j-glow/chwytak/mes/blok/PerformanceLog.txt

Number of Contacts: 0
Number of contact data: 0
