j-glow/chwytak/Sprawozdanie.docx

# Zakład Podstaw Kontrukcji

# ITLiMS, MEiL, PW

Podstawy Konstrukcji Maszyn

Rok akademicki 2022/2023, semestr zimowy

Projekt Chwytaka

Sprawozdanie z procesu projektowego

Autor

Jakub Głowacki

# 1 Wstęp

Chwytak miał spełniać zadanie przenoszenia piasku w drobnych pracach budowlanych. Do zastosowania w koparkach kołowych takich jak Komatsu 98MR-6. Praca odbywa się w różnych warunkach atmosferycznych, może występować wilgoć, pył oraz zmienne temperatury. Wymagana jest instalacja hydrauliczna do działania siłownika.

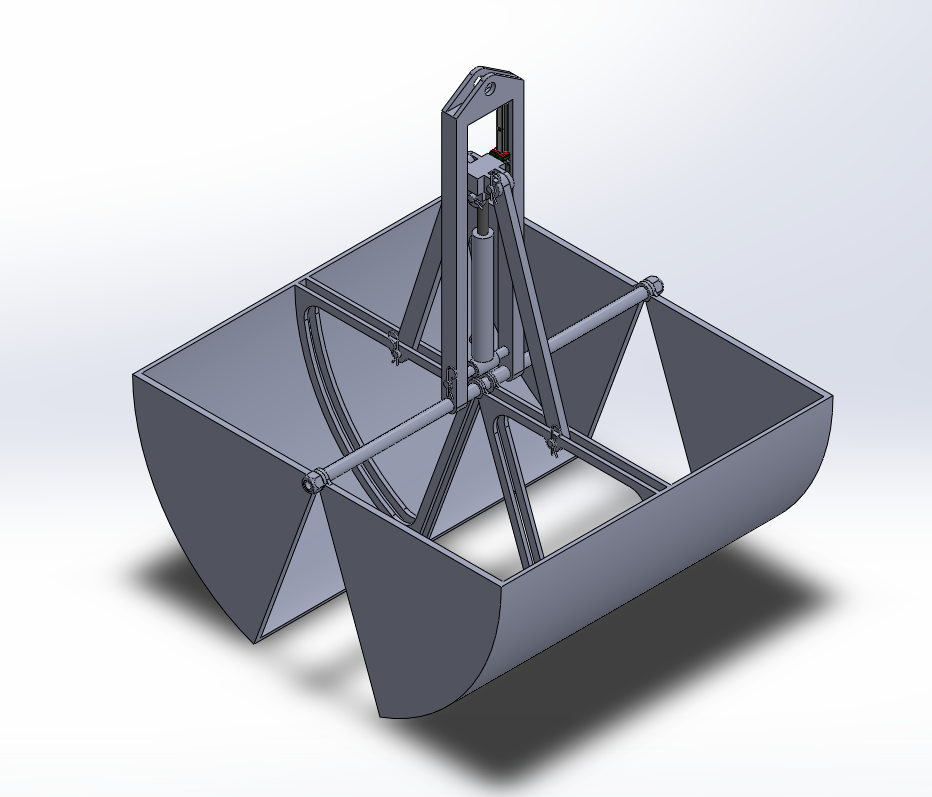
[picture p1: figure]

Rysunek 1 - wizualizacja chwytaka

# 2 Założenia

Aby zdefiniować proces projektowania potrzeba było założeń projektowych. Zaliczono do nich:

- pojemność użyteczna chwytaka – powyżej 100L,
- użycie tylko jednego siłownika w mechanizmie,
- możliwie jak największe ograniczenie wysokości całkowitej,
- moment domykający równy 1kNm,
- odporność na zniszczenie w przypadku zacisku na kamieniu,
- maksymalne przyspieszenia poruszające chwytakiem, oraz otwierające/zamykające chwytak nie większe niż 1G.

# 3 Schemat kinematyczny oraz statyka

## 3.1 Schemat Kinematyczny

Biorąc pod uwagę wymaganą pojemność i opierając się o wiedzę na temat dostępnych siłowników, przystąpiłem do stworzenia schematu kinematycznego siłownika. Rdzeniem mechanizmu jest siłownik montowany jednym końcem w osi obrotu łyżek, a drugim końcem do bloku przenoszącego siły napędowe na cięgna. Następnie będą one odpowiednio rozwierały, lub zwierały chwytak.

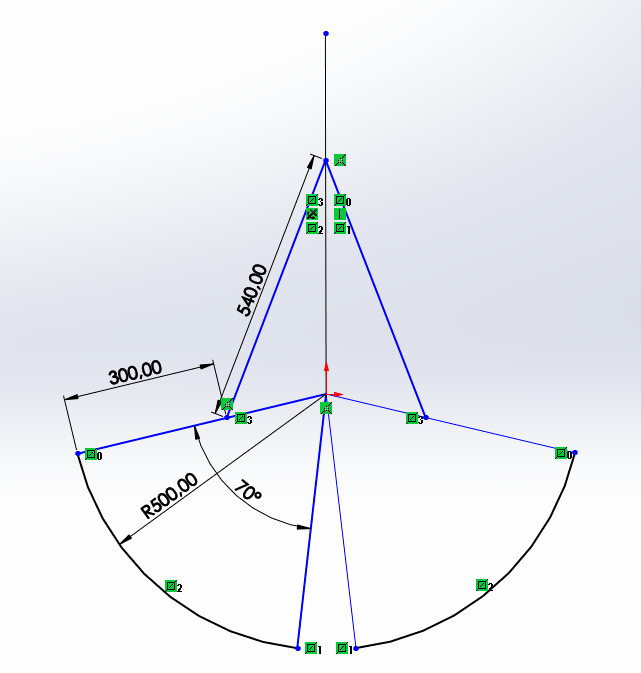
[picture p2: figure]

Rysunek 2 - schemat kinematyczny

Taki mechanizm pozwala nam na zminimalizowanie wysokości całego projektu – będzie ona równa promieniowi łyżki, długości maksymalnej siłownika oraz wysokości części montażowej. Dodatkowo można bardzo łatwo manipulować zmianami w geometrii projektu. Z łatwością da się zmieniać długość cięgien, oraz miejsce połączenia sworzniowego z cięgnem.

Dodatkowo wyliczam ruchliwość mechanizmu, zakładając że mechanizm posiada 3 człony, 4 pary kinematyczne V klasy, ze wzoru:

w=3*3-2*4=1

Co oznacza, że wymagany będzie jeden siłownik do pełnego sterowania chwytakiem.

## 3.2 Statyka

Po wprowadzeniu siły wymaganej do zamknięcia/rozwarcia chwytaka równej 1kN, możemy przystąpić do obliczania sił w poszczególnych węzłach, tak jak przedstawiono na rysunku.

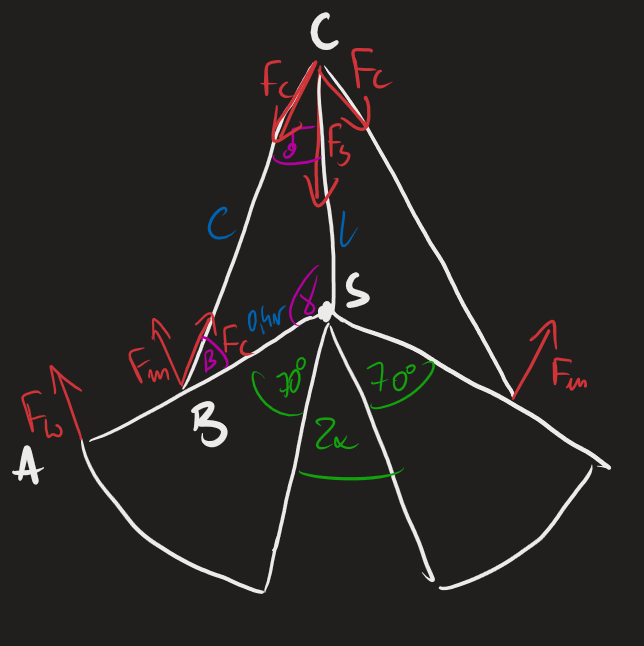
[picture p3: figure]

Rysunek 3 - siły w węzłach

Oznaczenia:

- FW – siła wymagana do zamknięcia rozwarcia
- FM – siła tworząca moment w skorupie łyżki ze względu na pracę cięgna
- FC – siła ściskająca/rozciągająca cięgno
- FS – siła z jaką działa siłownik

Najpierw obliczam wymaganą siłę obracającą łyżkę:

0,4r*F_M =r*F_W

F_M =2,5F_W

Wyznaczam kąt γ w zależności od kąta rozwarcia:

γ=110-α

Następnie mogę wyprowadzić funkcję długości siłownika od kąta γ:

c^2 =(r^2)/4+l^2 -r*l*cosγ

0=l^2 -r*l*cosγ+(r^2)/4-c^2

√(∆)=√(r^2 *cos^2 γ+4c^2 -r^2)

l=(r*cosγ+√(r^2 *cos^2 γ+4c^2 -r^2))/2

Obliczam teraz zależność siły w cięgnie od siły nadającej moment:

(F_M)/(F_C)=sinβ

F_C =(F_M)/(sinβ)

Wartość sin β znajduję przy pomocy twierdzenia sinusów:

c/(sinγ)=l/(sinβ)=r/(2sinδ)

Co daje nam wzór na siłę w cięgnie:

F_C =(c*F_M)/(l*sinγ)=(c*2,5F_W)/(l*sinγ)=(2c*2,5F_W)/((r*cosγ+√(r^2 *cos^2 γ+4c^2 -r^2))*sinγ)

W końcu liczę siłę siłownika:

(F_S)/(2F_C)=cosδ

F_S =2F_C *cosδ

Również z twierdzenia sinusów znajduję wartość sin δ dzięki któremu później wyliczam cos δ :

sinδ=(r*sinγ)/(2c)

cosδ=√(1-(r^2 *sin^2 γ)/(4c^2))=(√(4c^2 -r^2 *sin^2 γ))/(2c)

Podstawiam cos δ oraz FC do wzoru na FS otrzymując wzór na funkcję FS( γ ):

F_S =2*(2c*2,5F_W)/((r*cosγ+√(r^2 *cos^2 γ+4c^2 -r^2))*sinγ)*(√(4c^2 -r^2 *sin^2 γ))/(2c)

F_S (γ)=(5F_W *√(4c^2 -r^2 *sin^2 γ))/((r*cosγ+√(r^2 *cos^2 γ+4c^2 -r^2))*sinγ)

Uwzględniając, że γ=110-α , mogę wyznaczyć wykres siły wymaganej od kąta rozwarcia w oprogramowaniu MATLAB.

Dla kątów rozwarcia od 2α∈(0°,100°) otrzymujemy następujący wykres.

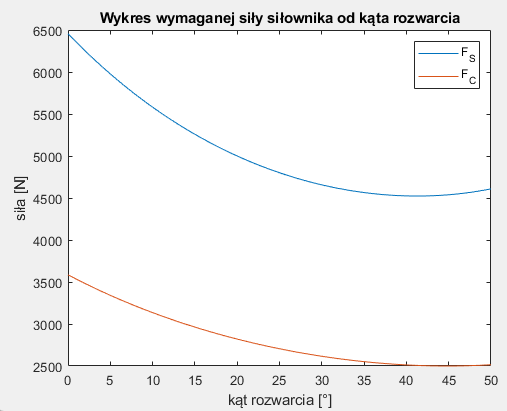
[picture p4: figure]

Rysunek 4 wykres FS( α )

Jak widać największa występująca siła jest nieco mniejsza od 6500N. Dodatkowo, uwzględniając, że cięgno będzie montowane w punkcie odsuniętym od linii ruchu bloku przenoszącego siły, ze względu na geometrię tego bloku, możemy przyjąć, że siły nie będą przekraczać 6,5kN. Posłuży nam to w następnych analizach wytrzymałościowych.

## 3.3 Dobór siłownika

Zważywszy na wymaganą geometrię, siły oraz charakter działania wybrany zostaje siłownik marki ANR Engineering o numerze katalogowym C043220150, znaleziony przeze mnie na stronie Traceparts.com.

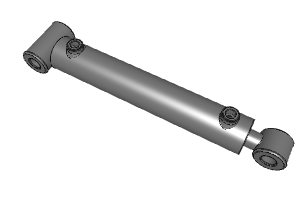
[picture p5: figure]

Rysunek 5 - model siłownika ANR Engineering

## 3.4 Dodatkowe części

Ze względu na obowiązek stabilizowania ruchu siłownika, wymagana jest prowadnica liniowa. Zgodnie z analizą geometryczną wybrana zostaje szyna wraz z wózkiem marki HIWIN. Jako, że nie będzie przenosić wysokich naprężeń, wybrany zostaje podstawowy rodzaj wózka o wymiarach pasujących do bloku. Uwzględnione zostały warunki w jakich pracuje chwytak, więc wózek będzie miał dodatkowe zabezpieczenia przed pyłem. Dokładna nota katalogowa prowadnicy wraz z wózkiem znajduje się w załącznikach.

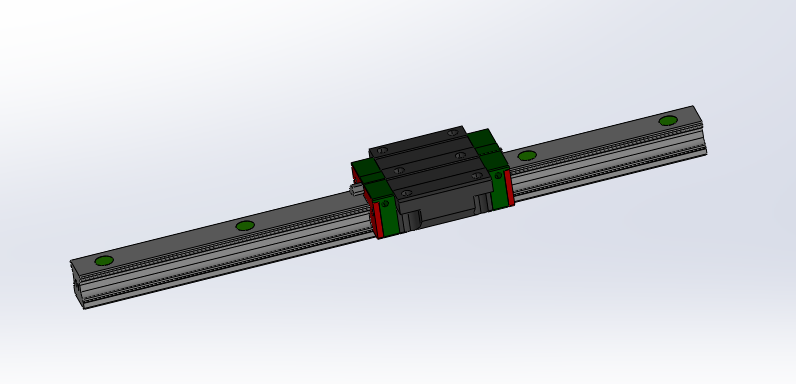
[picture p6: figure]

Rysunek 6 - prowadnica HIWIN

# 4 Wytrzymałość elementów

## 4.1 Cięgna

Pamiętając o tym, że siła w cięgnie wyraża się wzorem:

F_C =(c*F_M)/(l*sinγ)≤3,6kN

Mogę obliczyć naprężenia ściskające/rozciągające w cięgnie, siłę krytyczną wyboczenia, oraz wymaganą grubość sworznia.

### 4.1.1 Sworznie

Materiałem sworznia będzie stal nierdzewna 316l, co daje nam granicę plastyczności równą R_e =200MPa

Przyjmuje wartości według schematu poniżej:

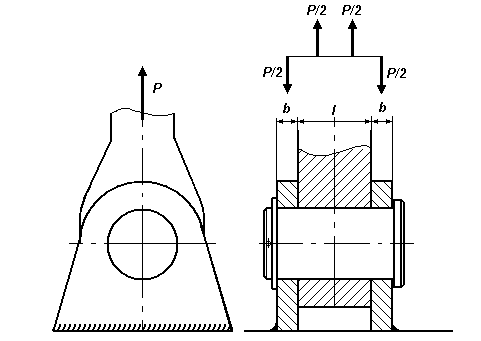
[picture p7: figure]

Rysunek 7 - połączenie sworzniowe luźne

- P=F_(Cmax) =3,6kN - siła w cięgnie
- b=10mm - grubość ucha
- l=20mm - grubość cięgna
- k_g =0,5Re=100MPa - maksymalne naprężenia w sworzniu

Wzór na naprężenia wyraża się następująco:

σ_g =(Mg)/(Wx)=(4P*(2b+l))/(π*d^3)<k_g

Co można przekształcić na wzór na minimalną grubość sworznia:

d≥³√((4P*(2b+l))/(π*k_g))=9,71mm

Przyjmuję uwzględniając współczynnik bezpieczeństwa równy 0,6, że sworzeń będzie miał średnicę równą 16mm.

Znając materiał ucha (stal konstrukcyjna S355, Re=470MPa), możemy obliczyć minimalną grubość ucha:

p=P/(d*l)≤k_d =0,5R_e

l≥P/(d*0,5R_e)= 1mm

Czyli 10mm grubości ucha jest wystarczające.

### 4.1.2 Tuleje ślizgowe

Według normy katalogowej tuleje te mogą wytrzymać naprężenia ściskające równe 78MPa. W celu sprawdzenia wytrzymałości przyjmuję model, w którym cała siła obciążająca rozkłada się równomiernie na ¼ obwodu. Wektory skierowane są wzdłuż promieni. Obszar, na który przypadać będzie siła ściskająca można wyznaczyć wzorem:

A=1/4*π*d_(zew) *l*n

Gdzie:

- d_(zew) =18mm – średnica zewnętrzna
- l=8 – długość tulei
- n=2 – ilość tulei w jednym połączeniu

Wraz ze wzorem na naprężenia ze względu na ściskanie dostajemy następujące wyniki:

σ=F/A=(4F_c)/(π*d_(zew) *l*n)=15,92 MPa

Wyliczone naprężenia nie przekraczają granicy wytrzymałości elementu.

### 4.1.3 Ściskanie/rozciąganie

Naprężenia ze względu na rozciąganie/ściskanie wyrażają się wzorem:

σ_r =F/A<k_r =0,5R_e

Przyjmuje dane materiałowe dla stali konstrukcyjnej S355, a przekrój poprzeczny za prostokąt o wymiarach 20mm x 40mm .

σ_r =(F_C)/(a*b)=4,5MPa≪k_r

### 4.1.4 Wyboczenie

W przypadku ściskania występuje możliwość wyboczenia. Możemy rozpatrzeć dwa przypadki. Pręt zamocowany w dwóch podstawach obrotowych dla zginania w płaszczyźnie XY, oraz pręt zamocowany z dwóch stron w ścianie dla zginania w płaszczyźnie XZ. Schemat cięgna widać na rysunku 6.

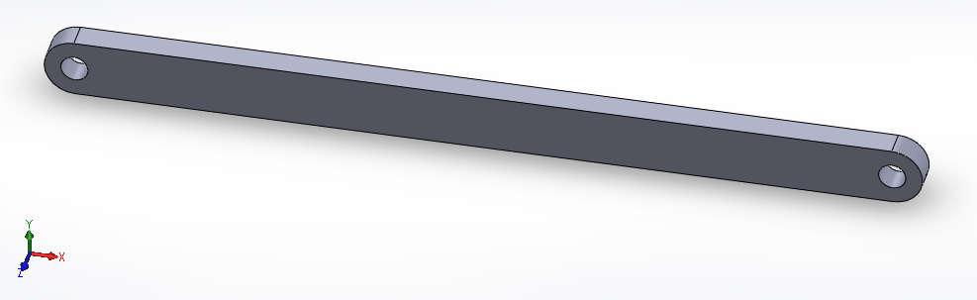
[picture p8: figure]
Obraz zawierający narzędzie Opis wygenerowany automatycznie

Rysunek 8 – cięgno

Siłę wybaczającą krytyczną opisujemy wzorem:

P_(kr) =(π^2 *E*I)/(l_s^2)

Dla tego przypadku mamy następujące wartości:

- E=2*10^5 MPa - moduł Younga
- b=20mm - grubość przekroju poprzecznego
- h=40mm - szerokość przekroju poprzecznego
- Iz=(b*h^3)/12=106 666 mm^4 - moment bezwładności dla osi Z
- I_y =(b^3 *h)/12=26 666 mm^4 - moment bezwładności dla osi Y
- l_(sy) =l=540mm - długość swobodna dla wyboczenia w stronę osi Y
- l_(sz) =0,5l=270mm - długość swobodna dla wyboczenia w stronę osi Z

Z czego możemy policzyć siłę krytyczną dla obu przypadków:

P_(maxy) =1,8*10^5 N≫3,6kN

P_(maxz) =2,9*10^6 N≫3,6kN

Skąd widać, że wyboczenie nie wystąpi.

## 4.2 Blok

### 4.2.1 Sworzeń siłownika

Analogicznie jak w przypadku cięgna wyliczam minimalną grubość sworznia. Wymiary oraz charakterystyka materiału jest identyczna, z wyjątkiem parametrów „l”, który teraz jest równy 30mm, oraz „b” 5mm.

d≥³√((4P*(2b+l))/(π*k_g))=9,71mm

Znów możemy przyjąć średnicę sworznia 16mm.

### 4.2.2 Analiza MES

Dodatkowo wykonałem analizę obciążenia bloku, którą widać na rysunku poniżej.

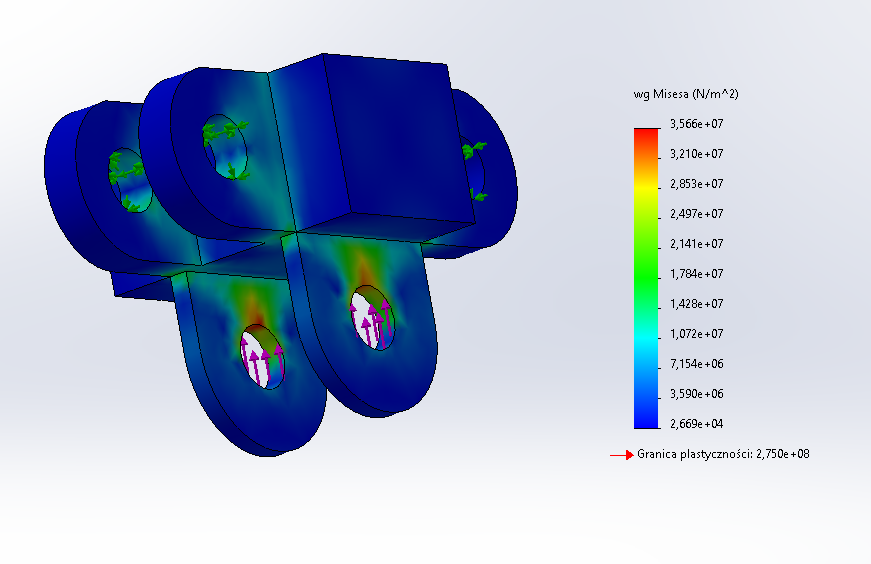
[picture p9: figure]

Rysunek 9 - MES dla bloku

Naprężenia nie przekraczają 36MPa, czyli nie jest przekroczona granica plastyczności

## 4.3 Łyżka

Łyżka została przeze mnie zbadana dla dwóch konfiguracji. Jedną z nich jest zamknięcie się na nieodkształcalnym kamieniu, drugą jest obciążenie piaskiem oraz docisk momentem. Wyniki prezentują się następująco:

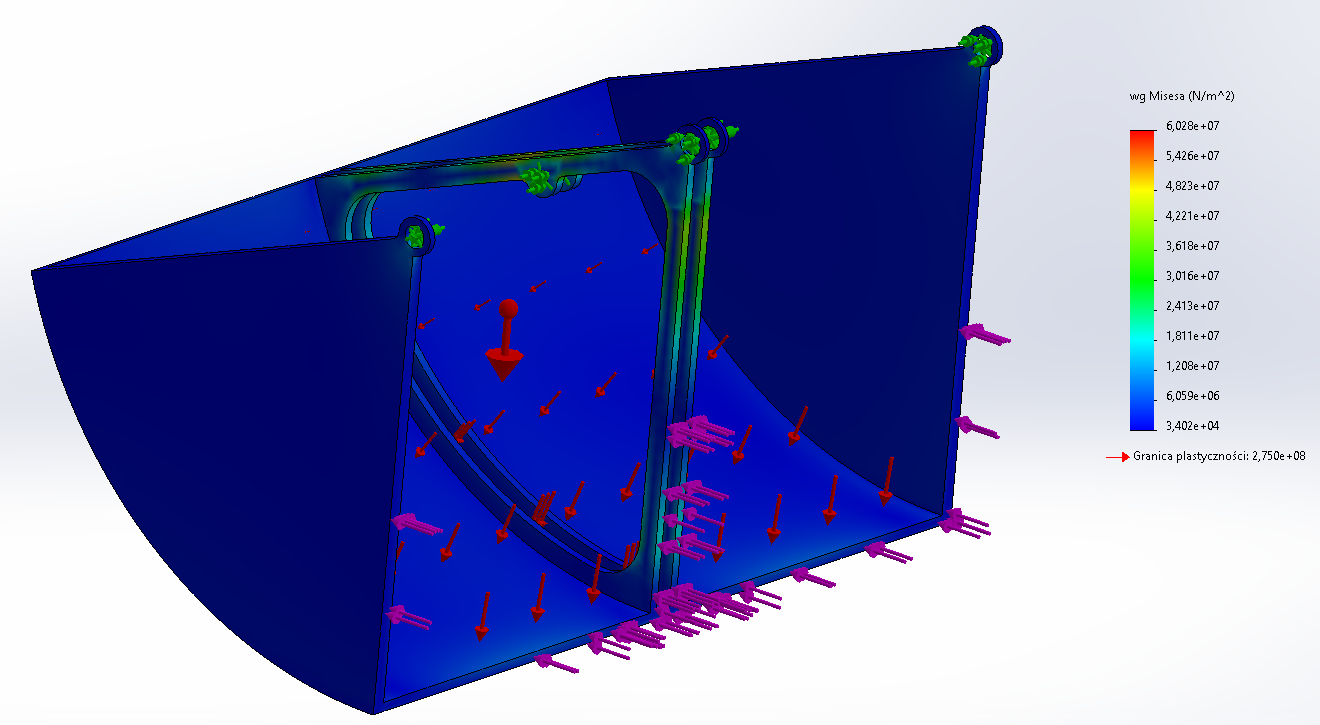
[picture p10: figure]
Obraz zawierający tekst, koperta Opis wygenerowany automatycznie

Rysunek 10 - obciążanie piaskiem i dociskiem

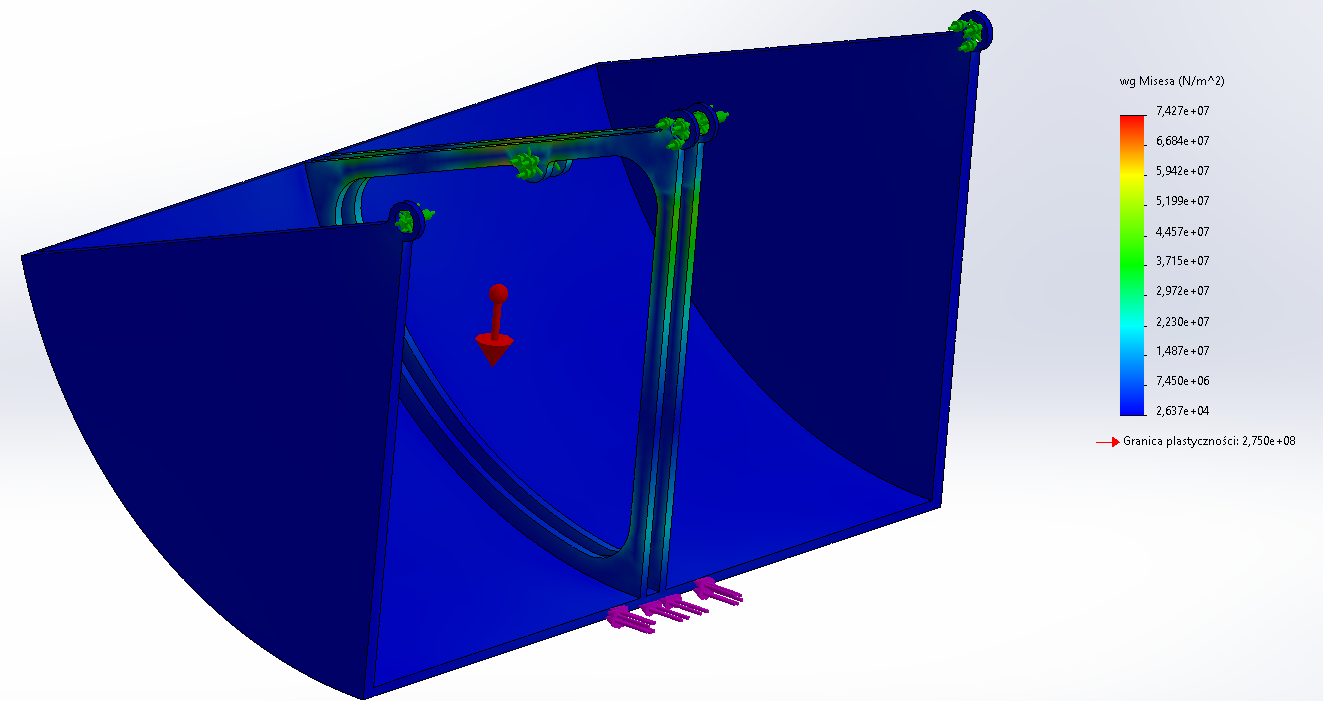
[picture p11: figure]
Obraz zawierający tekst, stacjonarne, koperta, grafika wektorowa Opis wygenerowany automatycznie

Rysunek 11 - zamknięcie się na kamieniu

W pierwszym przypadku naprężenia maksymalne wynoszą 61MPa, w drugim natomiast 75MPa, co nie przekracza granicy plastyczności. Przyspieszenie chwytaka nie przekracza 1G, dlatego sytuacja w której łyżka zmienia swoją prędkość obrotową nie będzie wykazywała naprężeń większych od naprężeń statycznych.

## 4.4 Siłownik

### 4.4.1 Sworzeń dolny siłownika

Jako model przyjmuje belkę unieruchomioną obustronnie w ścianie, w której środku jest przyłożona siła punktowa, jak na rysunku poniżej.

Rysunek 12 - model belki oraz rozkład momentu i siły

Aby obliczyć naprężenia maksymalne wykorzystam wzór na naprężenia od momentu zginającego:

σ_(zg) =(M_g *r)/I

Gdzie:

- P=6,5kN - siła maksymalna siłownika
- l=123mm - długość sworznia między utwierdzeniami
- M_g =(P*l)/8=100Nm - maksymalny moment gnący
- r=8mm - promień sworznia
- I=(π*r^4)/4=3217mm^4 - moment bezwładności

Skąd dostajemy wynik:

σ_(zg) =249MPa

Jest to poniżej granicy plastyczności dla stali S355J2G4. Jednak element ten będzie najbardziej narażony w modelu na zniszczenie ze względu na wytrzymałość zmęczeniową (naprężenia robocze bardzo bliskie granicy plastyczności materiału). W kolejnej iteracji projektu na pewno postarałbym się zmniejszyć naprężenia, oraz prawdopodobnie zmieniłbym sposób montażu siłownika ze strony łyżek.

### 4.4.2 Sworzeń montażowy stelaża

Cały siłownik montowany będzie do wysięgnika koparki przy pomocy połączenia sworzniowego mocującego stelaż (opcjonalnie pośrednio przez rotator, jednak połączenie sworzniowe w obu przypadkach ma taki sam rozmiar).

Modeluje połączenie sworzniowe w analogiczny sposób jak w przypadku cięgien oraz sworznia górnego siłownika.

Dane:

- m≤200kg - całkowita masa chwytaka (właściwości masy Solidworks)
- g=9,81 N/kg - przyspieszenie ziemskie
- P=m*g - siła w cięgnie
- b=10mm - grubość ucha
- l=20mm - grubość cięgna
- k_g =0,5Re=100MPa - maksymalne naprężenia w sworzniu

Ponownie wykorzystując wzór na minimalną średnicę sworznia uzyskujemy wynik:

d≥³√((4P*(2b+l))/(π*k_g))≅10mm

Co jest dużo mniejsze od założonej średnicy równej 28mm. Dzięki temu można pominąć w obliczeniach siły bezwładności chwytaka, ze względu na maksymalne przyspieszenia nie większe niż 1G.

# 5 Wykonanie i złożenie elementów

Ogólny proces złożenia chwytaka składa się z trzech kroków, gdy części są już wytworzone. Dokładne instrukcje wytwarzania poszczególnych części znajdować się będą w następnych podrozdziałach.

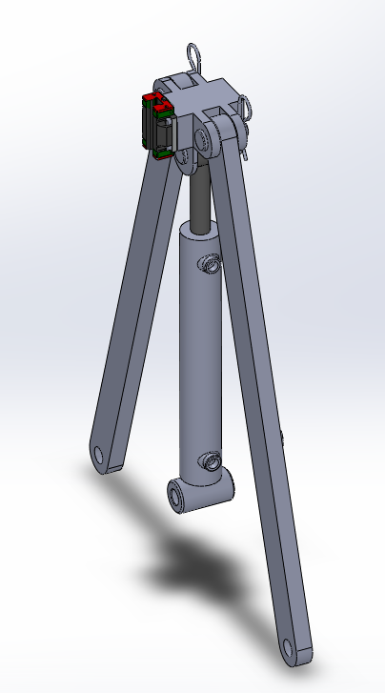
[picture p12: figure]
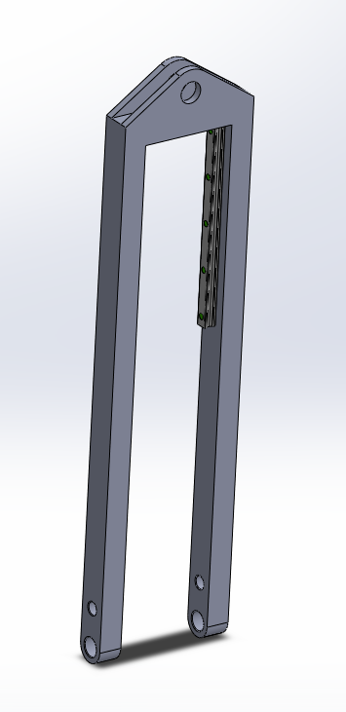
[picture p13: figure]
Obraz zawierający tekst Opis wygenerowany automatycznie
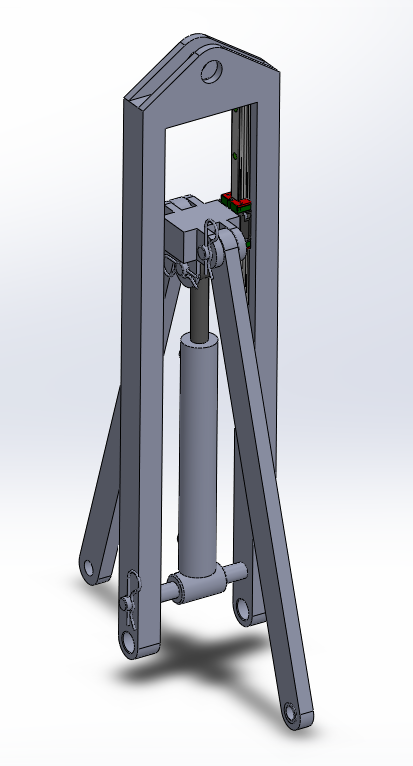
[picture p14: figure]

W celu złożenia chwytaka w pierwszej kolejności należy połączyć elementy stelaża, tj. wkręcić prowadnice, oraz przykręcić wózek prowadnicy do bloku. Przy montowaniu cięgien pamiętać należy o włożeniu między każdy sworzeń a cięgno dwóch tulei ślizgowych kołnierzowych. Wózek wraz z blokiem wsuwamy w prowadnicę. Dolną część siłownika montujemy poprzez długi sworzeń , który centrowany jest dwoma tulejami dystansowymi.

Rysunek 13 - stelaż

Rysunek 15 - złożenie stelaża z siłownikiem

Rysunek 14 - blok z siłownikiem

W następnym kroku należy trzpieniem chwytaka połączyć dwie łyżki oraz stelaż, jednocześnie wkładając go w odpowiednie tuleje dystansowe (z zewnątrz tuleje 343,5mm, wewnątrz 31,5mm). Następnie z obu stron blokujemy ruch trzpieniowi wzdłuż osi obrotu przy pomocy dwóch nakrętek samohamownych M24. Ostatnim krokiem jest złączenie cięgien z łyżkami przy pomocy sworzni, pamiętając jednocześnie o tulejach ślizgowych.

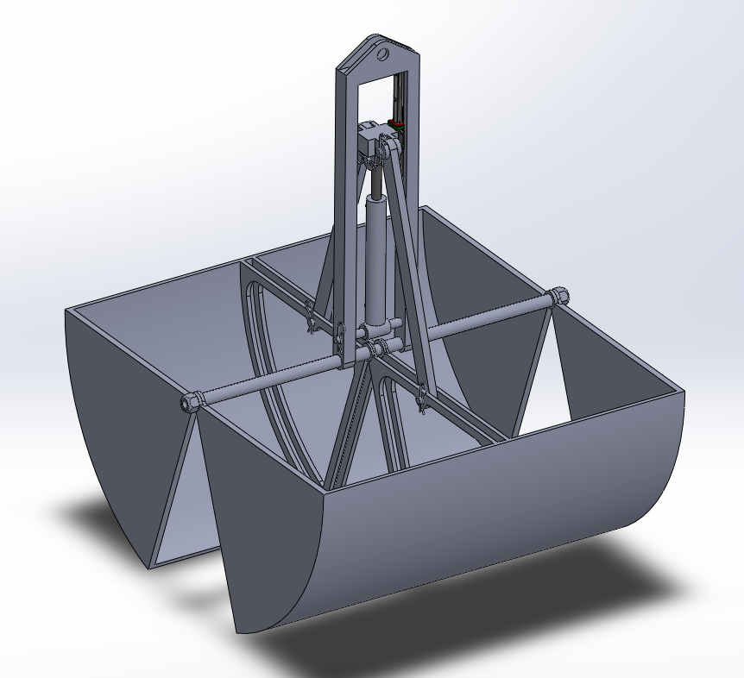
[picture p15: figure]
Obraz zawierający akcesorium Opis wygenerowany automatycznie

Rysunek 13 - pełne złożenie

## 5.1 Łyżka

Łyżka chwytaka wykonana jest taki sposób, aby można było stosować dokładnie ten sam model dwukrotnie w celu złożenia chwytaka. Wykonana jest z arkusza stali konstrukcyjnej S355J2G4 o grubości 10mm. Najpierw arkusz blachy o wymiarach 900x611mm gięty jest wzdłuż krótszej krawędzi na 70-stopniowy łuk koła. Następnie spawane są do niego boki, oraz żebra, w których występuje otwór na sworzeń. Służyć on będzie do przenoszenia siły napędowej z siłownika.

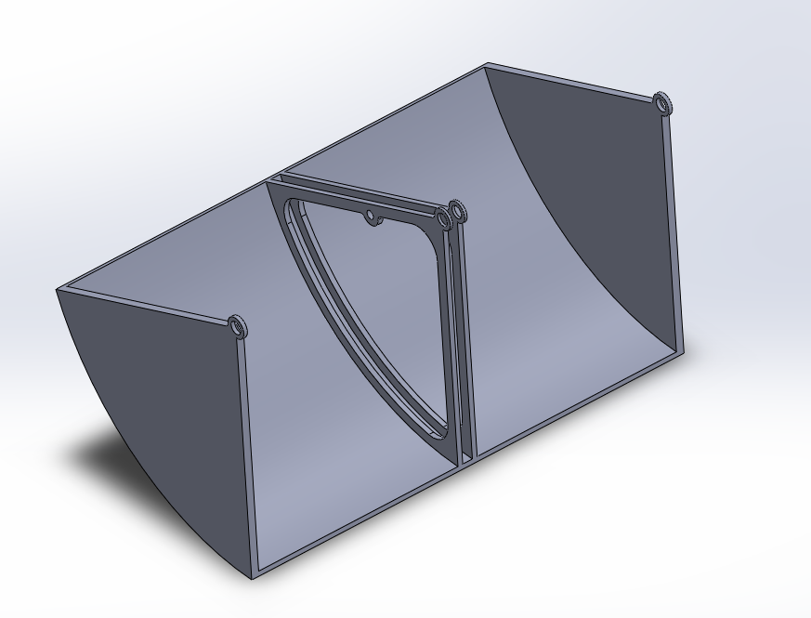
[picture p16: figure]
Obraz zawierający stacjonarne, futerał Opis wygenerowany automatycznie

Rysunek 14 - łyżka

## 5.2 Stelaż

Jest on spawany z dwóch długich belek o zaokrąglonym końcu, oraz jednej krótszej. Dospawane zostają ucha do montażu sworzniowego. Następnie ze względu na wymóg współosiowości wiercone są otwory na trzon, sworzeń dolny siłownika oraz sworzeń montażowy chwytaka. W ostatnim kroku wiercone oraz gwintowane są otwory montażowe prowadnicy w jednej z dłuższych belek stelaża.

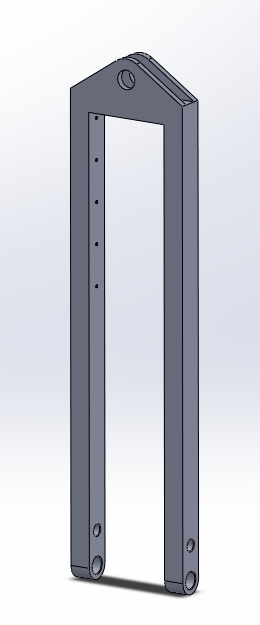
[picture p17: figure]

Rysunek 15 - stelaż

## 5.3 Blok przenoszący siły

Do nawierconego oraz nagwintowanego wcześniej bloku spawane są ucha do połączeń sworzniowych. W następnej kolejności pary uch są jednocześnie wiercone oraz wykańczane ze względu na potrzebę zachowania współosiowości otworów.

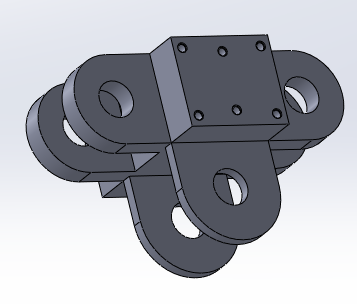
[picture p18: figure]
Obraz zawierający tekst, wyroby metalowe, sprzęt Opis wygenerowany automatycznie

Rysunek 16 - blok

# 6 Załączniki

- PKR-JG_00.00
- PKR-JG_01.00
- PKR-JG_01.01
- PKR-JG_01.02
- PKR-JG_01.03
- PKR-JG_01.04
- PKR-JG_02.00
- PKR-JG_02.01
- PKR-JG_02.02
- PKR-JG_02.03
- PKR-JG_02.04
- PKR-JG_03.00
- PKR-JG_03.01
- PKR-JG_03.02
- PKR-JG_03.03
- PKR-JG_03.04
- Dokumentacja Siłownika
- Dokumentacja Prowadnicy HIWIN
