j-glow/chwytak/PDF/Sprawozdanie.pdf

## Zakład Podstaw Kontrukcji ITLiMS, MEiL, PW

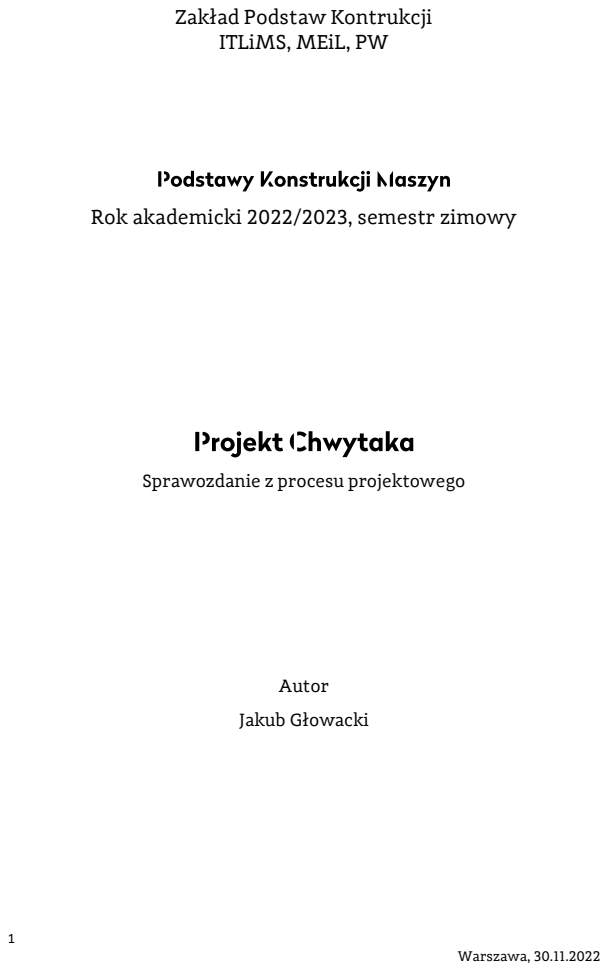
[picture p19: page 1]
Warszawa, 30.11.2022; Autor; Jakub Głowacki

Rok akademicki 2022/2023, semestr zimowy

Sprawozdanie z procesu projektowego

2

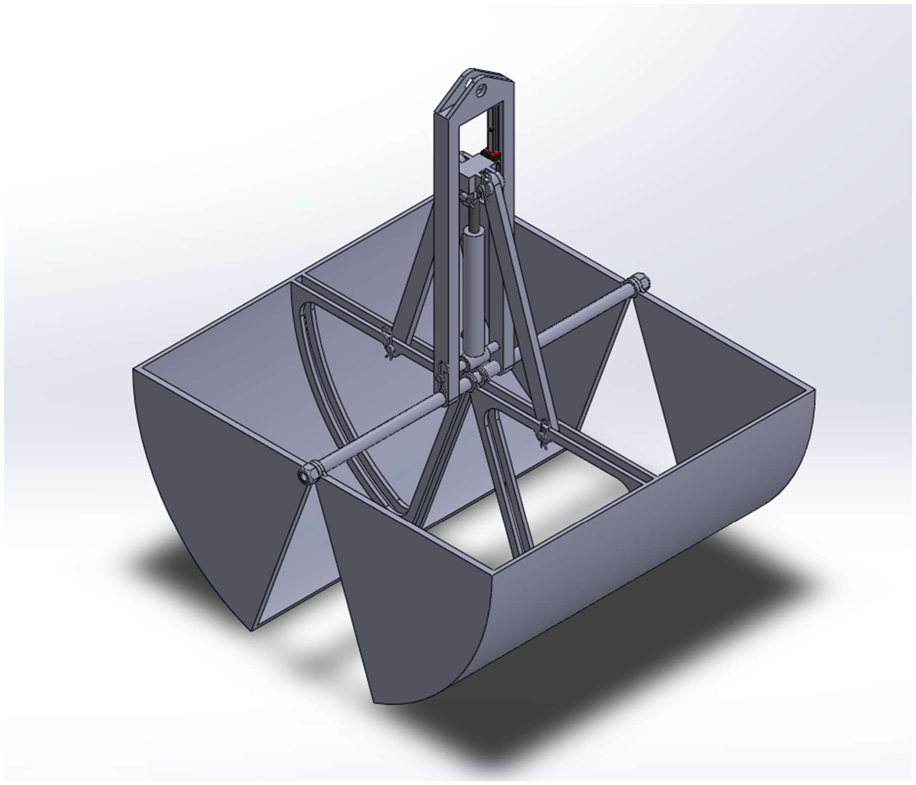
[picture p20: figure]

3

## 1 Wstęp

Chwytak miał spełniać zadanie przenoszenia piasku w drobnych pracach budowlanych. Do zastosowania w koparkach kołowych takich jak Komatsu 98MR-6. Praca odbywa się w różnych warunkach atmosferycznych, może występować wilgoć, pył oraz zmienne temperatury. Wymagana jest instalacja hydrauliczna do działania siłownika.

Rysunek 1 - wizualizacja chwytaka

## 2 Założenia

Aby zdefiniować proces projektowania potrzeba było założeń projektowych. Zaliczono do nich:
- pojemność użyteczna chwytaka – powyżej 100L,
- użycie tylko jednego siłownika w mechanizmie,
- możliwie jak największe ograniczenie wysokości całkowitej,
- moment domykający równy 1kNm,
- odporność na zniszczenie w przypadku zacisku na kamieniu,
- maksymalne przyspieszenia poruszające chwytakiem, oraz otwierające/zamykające chwytak nie większe niż 1G.

4

## 3 Schemat kinematyczny oraz statyka

### 3.1 Schemat Kinematyczny

Biorąc pod uwagę wymaganą pojemność i opierając się o wiedzę na temat dostępnych siłowników, przystąpiłem do stworzenia schematu kinematycznego siłownika. Rdzeniem mechanizmu jest siłownik montowany jednym końcem w osi obrotu łyżek, a drugim końcem do bloku przenoszącego siły napędowe na cięgna. Następnie będą one odpowiednio rozwierały, lub zwierały chwytak.

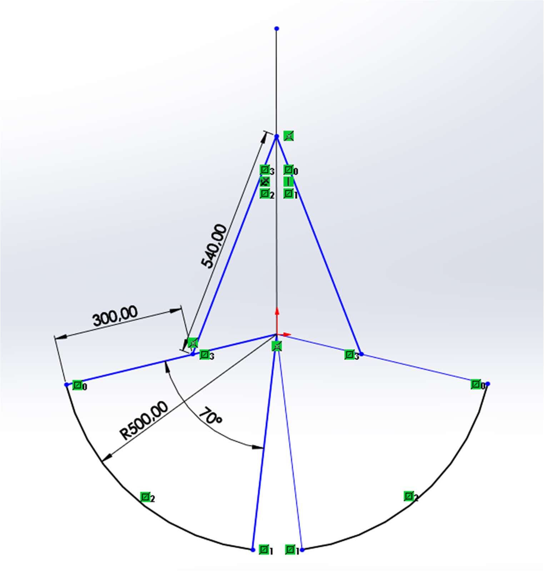
[picture p21: figure]

Rysunek 2 - schemat kinematyczny
Taki mechanizm pozwala nam na zminimalizowanie wysokości całego projektu – będzie ona równa promieniowi łyżki, długości maksymalnej siłownika oraz wysokości części montażowej. Dodatkowo można bardzo łatwo manipulować zmianami w geometrii projektu. Z łatwością da się zmieniać długość cięgien, oraz miejsce połączenia sworzniowego z cięgnem.
Dodatkowo wyliczam ruchliwość mechanizmu, zakładając że mechanizm posiada 3 człony, 4 pary kinematyczne V klasy, ze wzoru:

w = 3 ∗ 3 − 2 ∗ 4 = 1
Co oznacza, że wymagany będzie jeden siłownik do pełnego sterowania chwytakiem.

5

### 3.2 Statyka

Po wprowadzeniu siły wymaganej do zamknięcia/rozwarcia chwytaka równej 1kN, możemy przystąpić do obliczania sił w poszczególnych węzłach, tak jak przedstawiono na rysunku.

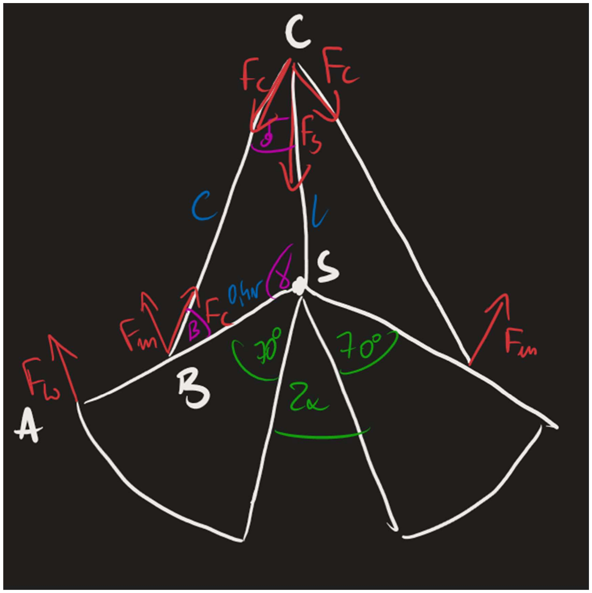
[picture p22: figure]

Rysunek 3 - siły w węzłach
Oznaczenia:
- FW – siła wymagana do zamknięcia rozwarcia
- FM – siła tworząca moment w skorupie łyżki ze względu na pracę cięgna
- FC – siła ściskająca/rozciągająca cięgno
- FS – siła z jaką działa siłownik
Najpierw obliczam wymaganą siłę obracającą łyżkę:

0,4r ∗ F = r ∗ F

F = 2,5F
Wyznaczam kąt γ w zależności od kąta rozwarcia:

γ = 110 − α

6

Następnie mogę wyprowadzić funkcję długości siłownika od kąta γ:

c

=

r

4

+ l

− r ∗ l ∗ cosγ

0 = l

− r ∗ l ∗ cosγ +

r

4

− c

√∆= r
∗ cos γ + 4c

− r

l =

r ∗ cosγ + r
∗ cos γ + 4c

− r

2
Obliczam teraz zależność siły w cięgnie od siły nadającej moment:

F
F

= sinβ

F =

F
sinβ
Wartość sinβ znajduję przy pomocy twierdzenia sinusów:

c
sinγ

=

l
sinβ =

r
2sinδ
Co daje nam wzór na siłę w cięgnie:

F =

c ∗ F
l ∗ sinγ

=

c ∗ 2,5F
l ∗ sinγ

=

2c ∗ 2,5F
(r ∗ cosγ + r
∗ cos γ + 4c

− r

) ∗ sinγ
W końcu liczę siłę siłownika:

F
2F

= cosδ

F = 2F ∗ cosδ
Również z twierdzenia sinusów znajduję wartość sinδ dzięki któremu później wyliczam cosδ:

sinδ =

r ∗ sinγ
2c

cosδ = 1 −
r

∗ sin γ
4c

=

4c
− r

∗ sin γ
2c
Podstawiam cosδ oraz FC do wzoru na FS otrzymując wzór na funkcję FS(γ):

F = 2 ∗

2c ∗ 2,5F
(r ∗ cosγ + r
∗ cos γ + 4c

− r

) ∗ sinγ

∗

4c
− r

∗ sin γ
2c

F(γ) =

5F ∗ 4c
− r

∗ sin γ
r ∗ cosγ + r
∗ cos γ + 4c

− r

∗ sinγ

Uwzględniając, że γ = 110 − α, mogę wyznaczyć wykres siły wymaganej od kąta rozwarcia w oprogramowaniu MATLAB.

7

Dla kątów rozwarcia od 2α ∈ (0°, 100°) otrzymujemy następujący wykres.

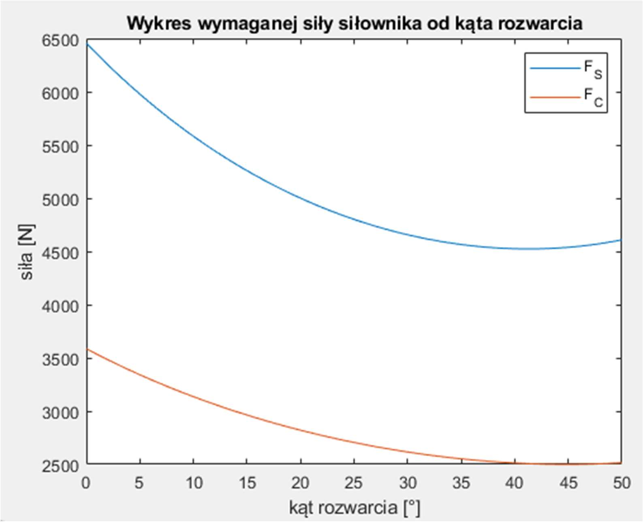
[picture p23: figure]

Rysunek 4 wykres FS(α)
Jak widać największa występująca siła jest nieco mniejsza od 6500N. Dodatkowo, uwzględniając, że cięgno będzie montowane w punkcie odsuniętym od linii ruchu bloku przenoszącego siły, ze względu na geometrię tego bloku, możemy przyjąć, że siły nie będą przekraczać 6,5kN. Posłuży nam to w następnych analizach wytrzymałościowych.

### 3.3 Dobór siłownika

Zważywszy na wymaganą geometrię, siły oraz charakter działania wybrany zostaje siłownik marki ANR Engineering o numerze katalogowym C043220150, znaleziony przeze mnie na stronie Traceparts.com.

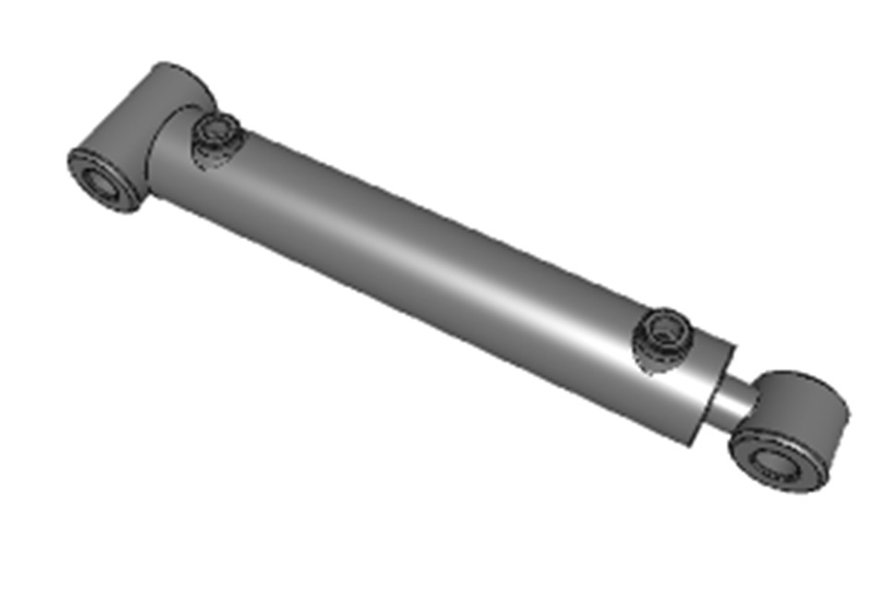
[picture p24: figure]

Rysunek 5 - model siłownika ANR Engineering

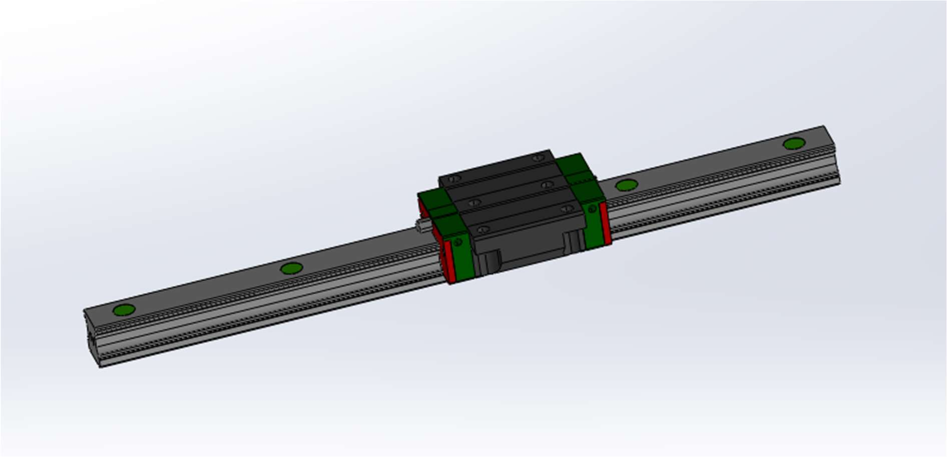
[picture p25: figure]

8

### 3.4 Dodatkowe części

Ze względu na obowiązek stabilizowania ruchu siłownika, wymagana jest prowadnica liniowa. Zgodnie z analizą geometryczną wybrana zostaje szyna wraz z wózkiem marki HIWIN. Jako, że nie będzie przenosić wysokich naprężeń, wybrany zostaje podstawowy rodzaj wózka o wymiarach pasujących do bloku. Uwzględnione zostały warunki w jakich pracuje chwytak, więc wózek będzie miał dodatkowe zabezpieczenia przed pyłem. Dokładna nota katalogowa prowadnicy wraz z wózkiem znajduje się w załącznikach.

Rysunek 6 - prowadnica HIWIN

## 4 Wytrzymałość elementów

### 4.1 Cięgna

Pamiętając o tym, że siła w cięgnie wyraża się wzorem:

F =

c ∗ F
l ∗ sinγ ≤ 3,6kN

Mogę obliczyć naprężenia ściskające/rozciągające w cięgnie, siłę krytyczną wyboczenia, oraz wymaganą grubość sworznia.

### 4.1.1 Sworznie

Materiałem sworznia będzie stal nierdzewna 316l, co daje nam granicę plastyczności równą
R = 200MPa
Przyjmuje wartości według schematu poniżej:

9

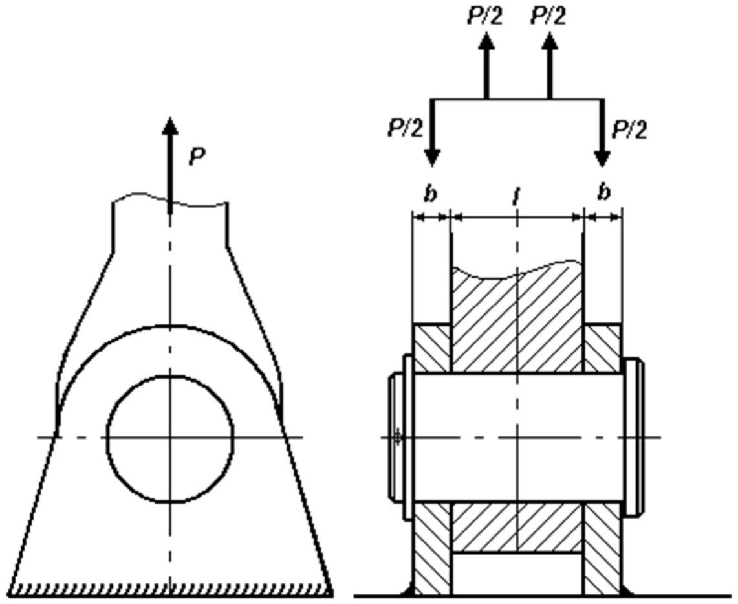
[picture p26: figure]

Rysunek 7 - połączenie sworzniowe luźne
- P = F = 3,6kN | - siła w cięgnie
- b = 10mm | - grubość ucha
- l = 20mm | - grubość cięgna
- k = 0,5Re = 100MPa | - maksymalne naprężenia w sworzniu

Wzór na naprężenia wyraża się następująco:

σ =

Mg
Wx =

4P ∗ (2b + l)
π ∗ d < k

Co można przekształcić na wzór na minimalną grubość sworznia:

d ≥
4P ∗ (2b + l)
π ∗ k
= 9,71mm

Przyjmuję uwzględniając współczynnik bezpieczeństwa równy 0,6, że sworzeń będzie miał średnicę równą 16mm.
Znając materiał ucha (stal konstrukcyjna S355, Re=470MPa), możemy obliczyć minimalną grubość ucha:

p =

P
d ∗ l ≤ k = 0,5R

l ≥ ∗,
=1mm

Czyli 10mm grubości ucha jest wystarczające.

### 4.1.2 Tuleje ślizgowe

Według normy katalogowej tuleje te mogą wytrzymać naprężenia ściskające równe 78MPa. W celu sprawdzenia wytrzymałości przyjmuję model, w którym cała siła obciążająca rozkłada się równomiernie na ¼ obwodu. Wektory skierowane są wzdłuż promieni. Obszar, na który przypadać będzie siła ściskająca można wyznaczyć wzorem:

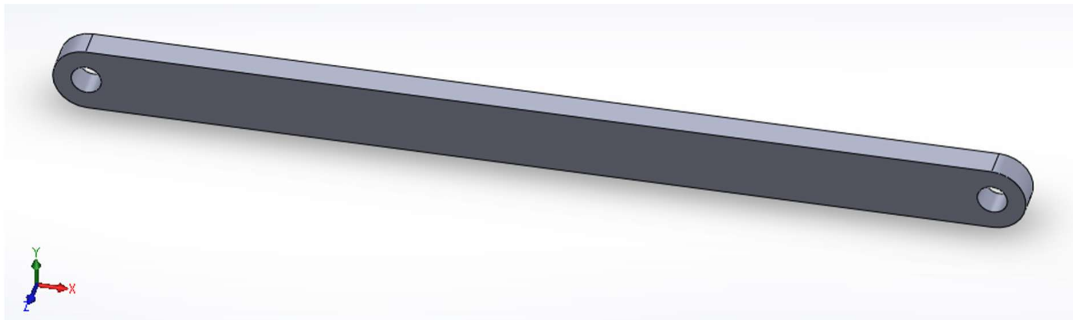
[picture p27: figure]

10

A =

1
4

∗ π ∗ d ∗ l ∗ n

Gdzie:
- d = 18mm | – średnica zewnętrzna
- l = 8 | – długość tulei
- n = 2 | – ilość tulei w jednym połączeniu
Wraz ze wzorem na naprężenia ze względu na ściskanie dostajemy następujące wyniki:
| σ = F
| A = 4F π ∗ d ∗ l ∗ n = 15,92 MPa

Wyliczone naprężenia nie przekraczają granicy wytrzymałości elementu.

### 4.1.3 Ściskanie/rozciąganie

Naprężenia ze względu na rozciąganie/ściskanie wyrażają się wzorem:

| σ = F
| A < k = 0,5R

Przyjmuje dane materiałowe dla stali konstrukcyjnej S355, a przekrój poprzeczny za prostokąt o
wymiarach 20mm x 40mm.
| σ = F a ∗ b = 4,5MPa ≪ k

### 4.1.4 Wyboczenie

W przypadku ściskania występuje możliwość wyboczenia. Możemy rozpatrzeć dwa przypadki. Pręt zamocowany w dwóch podstawach obrotowych dla zginania w płaszczyźnie XY, oraz pręt zamocowany z dwóch stron w ścianie dla zginania w płaszczyźnie XZ. Schemat cięgna widać na rysunku 6.

Rysunek 8 – cięgno
Siłę wybaczającą krytyczną opisujemy wzorem:

P =

π

∗ E ∗ I
l

11

Dla tego przypadku mamy następujące wartości:
- E = 2 ∗ 10MPa | - moduł Younga
- b = 20mm | - grubość przekroju poprzecznego
- ℎ = 40mm | - szerokość przekroju poprzecznego
- Iz = ∗

= 106 666 mm

- moment bezwładności dla osi Z
- I =

∗

= 26 666 mm

- moment bezwładności dla osi Y
- l = l = 540mm | - długość swobodna dla wyboczenia w stronę osi Y
- l = 0,5l = 270mm | - długość swobodna dla wyboczenia w stronę osi Z
Z czego możemy policzyć siłę krytyczną dla obu przypadków:
| P = 1,8 ∗ 10N ≫ 3,6kN
| P = 2,9 ∗ 10N ≫ 3,6kN
Skąd widać, że wyboczenie nie wystąpi.

### 4.2 Blok

### 4.2.1 Sworzeń siłownika

Analogicznie jak w przypadku cięgna wyliczam minimalną grubość sworznia. Wymiary oraz charakterystyka materiału jest identyczna, z wyjątkiem parametrów „l”, który teraz jest równy 30mm, oraz „b” 5mm.

| d ≥ 4P ∗ (2b + l)
| π ∗ k
= 9,71mm

Znów możemy przyjąć średnicę sworznia 16mm.

### 4.2.2 Analiza MES

Dodatkowo wykonałem analizę obciążenia bloku, którą widać na rysunku poniżej.

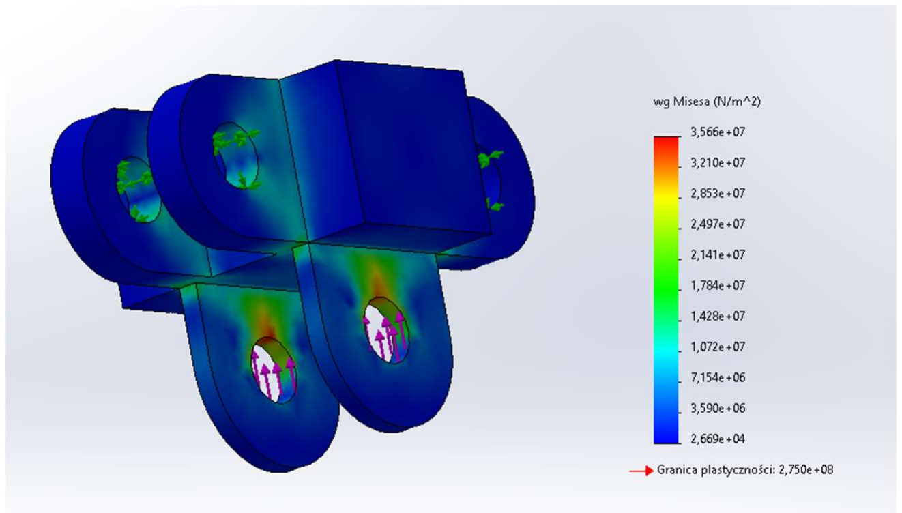
[picture p28: figure]

Rysunek 9 - MES dla bloku
Naprężenia nie przekraczają 36MPa, czyli nie jest przekroczona granica plastyczności

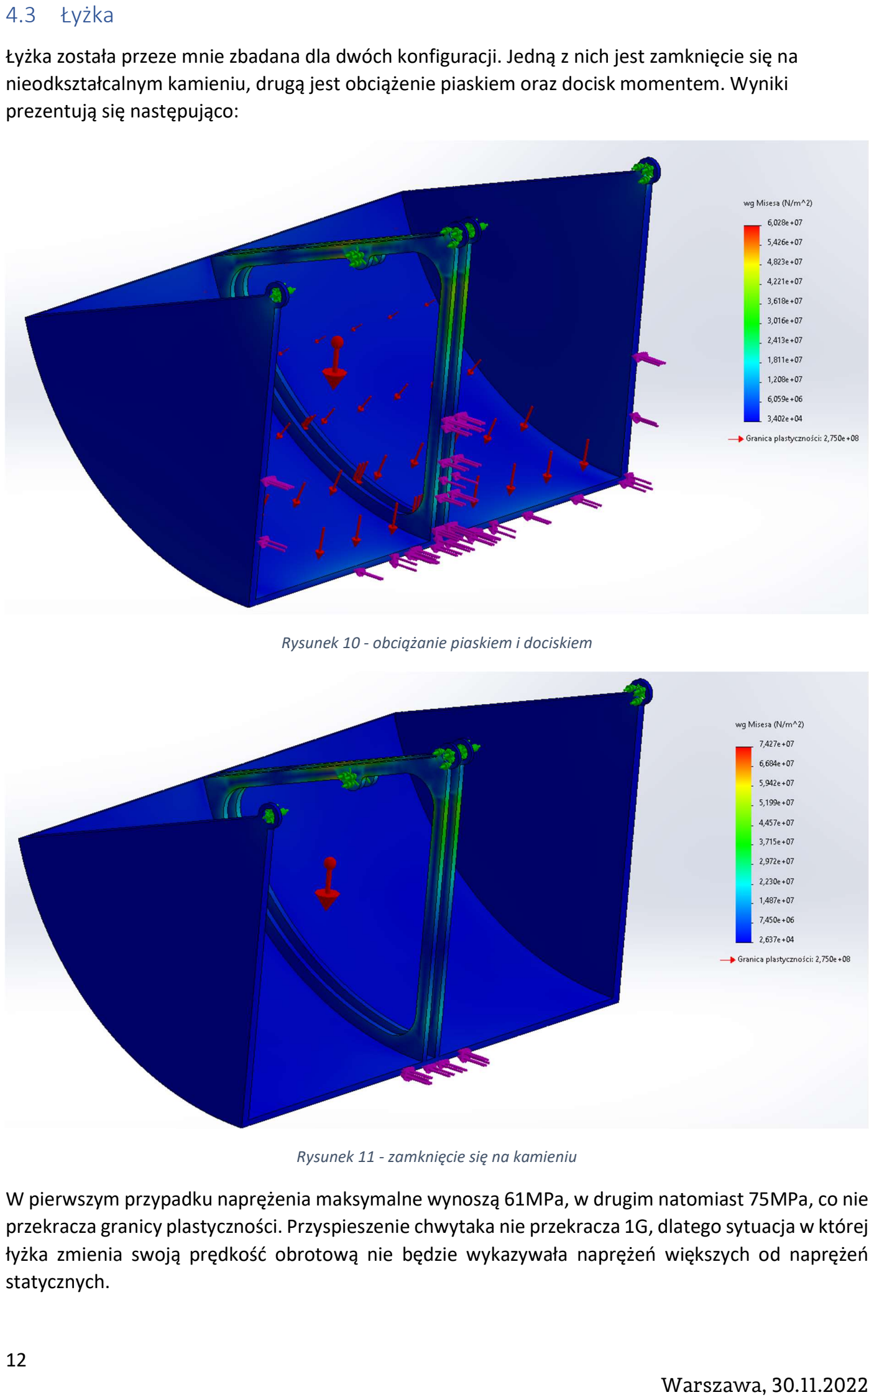
[picture p29: page 12]

12

### 4.3 Łyżka

Łyżka została przeze mnie zbadana dla dwóch konfiguracji. Jedną z nich jest zamknięcie się na nieodkształcalnym kamieniu, drugą jest obciążenie piaskiem oraz docisk momentem. Wyniki prezentują się następująco:

Rysunek 10 - obciążanie piaskiem i dociskiem

Rysunek 11 - zamknięcie się na kamieniu
W pierwszym przypadku naprężenia maksymalne wynoszą 61MPa, w drugim natomiast 75MPa, co nie przekracza granicy plastyczności. Przyspieszenie chwytaka nie przekracza 1G, dlatego sytuacja w której łyżka zmienia swoją prędkość obrotową nie będzie wykazywała naprężeń większych od naprężeń statycznych.

13

### 4.4 Siłownik

### 4.4.1 Sworzeń dolny siłownika

Jako model przyjmuje belkę unieruchomioną obustronnie w ścianie, w której środku jest przyłożona siła punktowa, jak na rysunku poniżej.

Rysunek 12 - model belki oraz rozkład momentu i siły
Aby obliczyć naprężenia maksymalne wykorzystam wzór na naprężenia od momentu zginającego:

σ =

M ∗ r
I
Gdzie:
- P = 6,5kN | - siła maksymalna siłownika
- l = 123mm | - długość sworznia między utwierdzeniami
- M =

∗
= 100Nm | - maksymalny moment gnący
- r = 8mm | - promień sworznia
- I =

∗

= 3217mm

- moment bezwładności

Skąd dostajemy wynik:

| σ = 249MPa
Jest to poniżej granicy plastyczności dla stali S355J2G4. Jednak element ten będzie najbardziej narażony w modelu na zniszczenie ze względu na wytrzymałość zmęczeniową (naprężenia robocze bardzo bliskie granicy plastyczności materiału). W kolejnej iteracji projektu na pewno postarałbym się zmniejszyć naprężenia, oraz prawdopodobnie zmieniłbym sposób montażu siłownika ze strony łyżek.

### 4.4.2 Sworzeń montażowy stelaża

Cały siłownik montowany będzie do wysięgnika koparki przy pomocy połączenia sworzniowego mocującego stelaż (opcjonalnie pośrednio przez rotator, jednak połączenie sworzniowe w obu przypadkach ma taki sam rozmiar).
Modeluje połączenie sworzniowe w analogiczny sposób jak w przypadku cięgien oraz sworznia górnego siłownika.

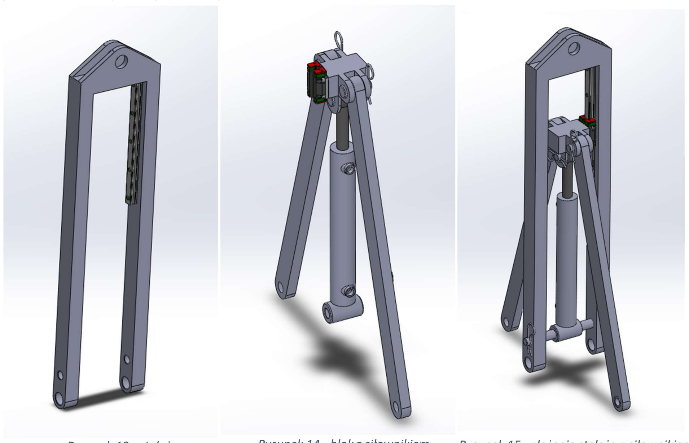
[picture p30: figure]

14

Dane:
- m ≤ 200kg | - całkowita masa chwytaka (właściwości masy Solidworks)
- g = 9,81 N/kg | - przyspieszenie ziemskie
- P = m ∗ g | - siła w cięgnie
- b = 10mm | - grubość ucha
- l = 20mm | - grubość cięgna
- k = 0,5Re = 100MPa - maksymalne naprężenia w sworzniu

Ponownie wykorzystując wzór na minimalną średnicę sworznia uzyskujemy wynik:

| d ≥ 4P ∗ (2b + l)
| π ∗ k
≅ 10mm

Co jest dużo mniejsze od założonej średnicy równej 28mm. Dzięki temu można pominąć w obliczeniach siły bezwładności chwytaka, ze względu na maksymalne przyspieszenia nie większe niż 1G.

## 5 Wykonanie i złożenie elementów

Ogólny proces złożenia chwytaka składa się z trzech kroków, gdy części są już wytworzone. Dokładne instrukcje wytwarzania poszczególnych części znajdować się będą w następnych podrozdziałach.
W celu złożenia chwytaka w pierwszej kolejności należy połączyć elementy stelaża, tj. wkręcić prowadnice, oraz przykręcić wózek prowadnicy do bloku. Przy montowaniu cięgien pamiętać należy o włożeniu między każdy sworzeń a cięgno dwóch tulei ślizgowych kołnierzowych. Wózek wraz z blokiem wsuwamy w prowadnicę. Dolną część siłownika montujemy poprzez długi sworzeń , który centrowany jest dwoma tulejami dystansowymi.
Rysunek 13 - stelaż | Rysunek 14 - blok z siłownikiem | Rysunek 15 - złożenie stelaża z siłownikiem

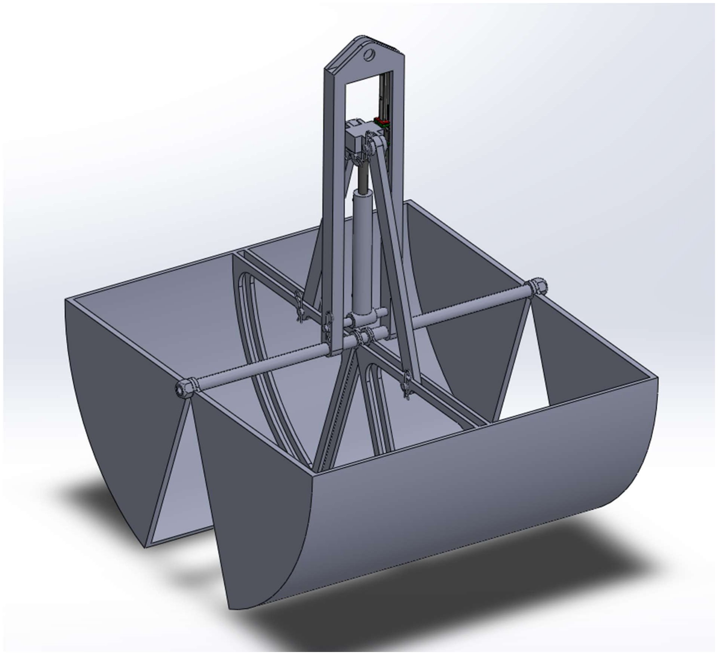
[picture p31: figure]

15

W następnym kroku należy trzpieniem chwytaka połączyć dwie łyżki oraz stelaż, jednocześnie wkładając go w odpowiednie tuleje dystansowe (z zewnątrz tuleje 343,5mm, wewnątrz 31,5mm). Następnie z obu stron blokujemy ruch trzpieniowi wzdłuż osi obrotu przy pomocy dwóch nakrętek samohamownych M24. Ostatnim krokiem jest złączenie cięgien z łyżkami przy pomocy sworzni, pamiętając jednocześnie o tulejach ślizgowych.

Rysunek 13 - pełne złożenie

### 5.1 Łyżka

Łyżka chwytaka wykonana jest taki sposób, aby można było stosować dokładnie ten sam model dwukrotnie w celu złożenia chwytaka. Wykonana jest z arkusza stali konstrukcyjnej S355J2G4 o grubości 10mm. Najpierw arkusz blachy o wymiarach 900x611mm gięty jest wzdłuż krótszej krawędzi na 70-stopniowy łuk koła. Następnie spawane są do niego boki, oraz żebra, w których występuje otwór na sworzeń. Służyć on będzie do przenoszenia siły napędowej z siłownika.

16

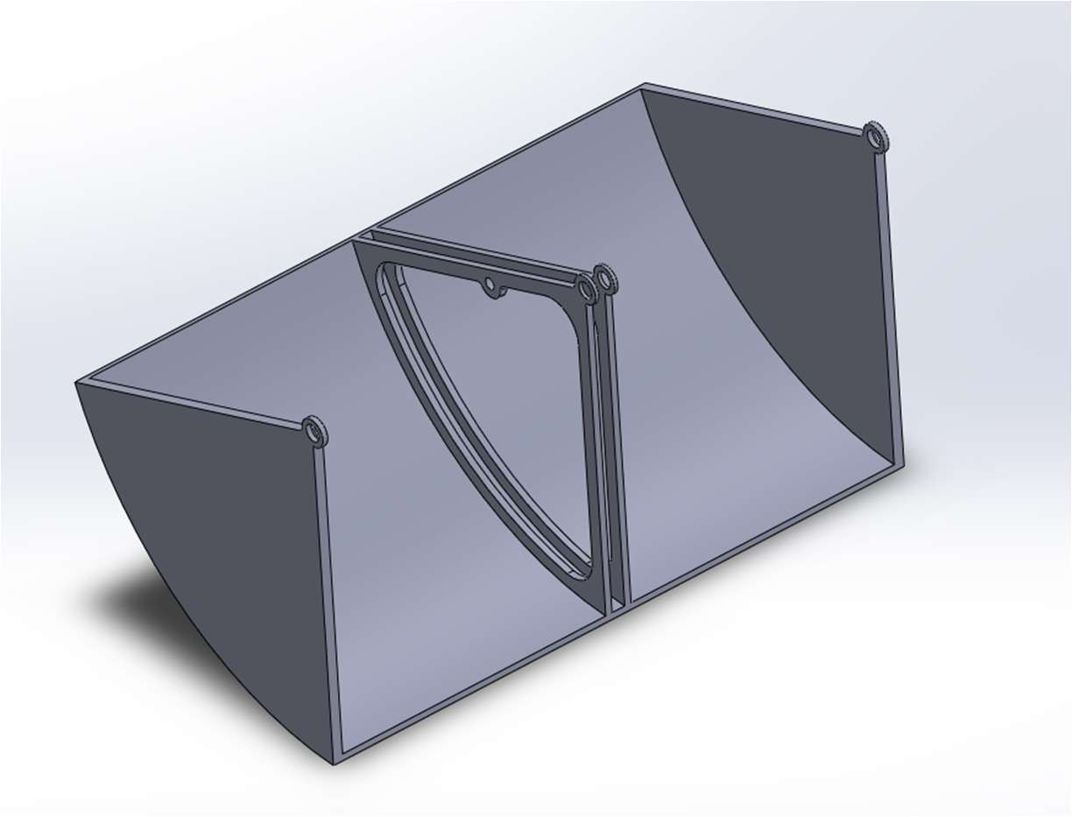
[picture p32: figure]

Rysunek 14 - łyżka

### 5.2 Stelaż

Jest on spawany z dwóch długich belek o zaokrąglonym końcu, oraz jednej krótszej. Dospawane zostają ucha do montażu sworzniowego. Następnie ze względu na wymóg współosiowości wiercone są otwory na trzon, sworzeń dolny siłownika oraz sworzeń montażowy chwytaka. W ostatnim kroku wiercone oraz gwintowane są otwory montażowe prowadnicy w jednej z dłuższych belek stelaża.

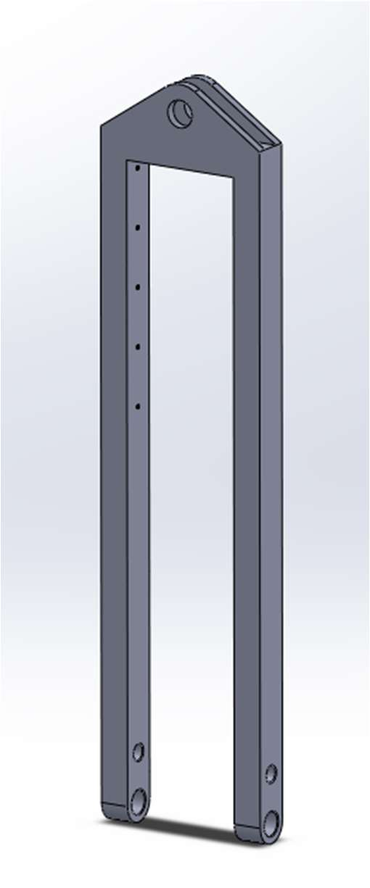
[picture p33: figure]

Rysunek 15 - stelaż

17

### 5.3 Blok przenoszący siły

Do nawierconego oraz nagwintowanego wcześniej bloku spawane są ucha do połączeń sworzniowych. W następnej kolejności pary uch są jednocześnie wiercone oraz wykańczane ze względu na potrzebę zachowania współosiowości otworów.

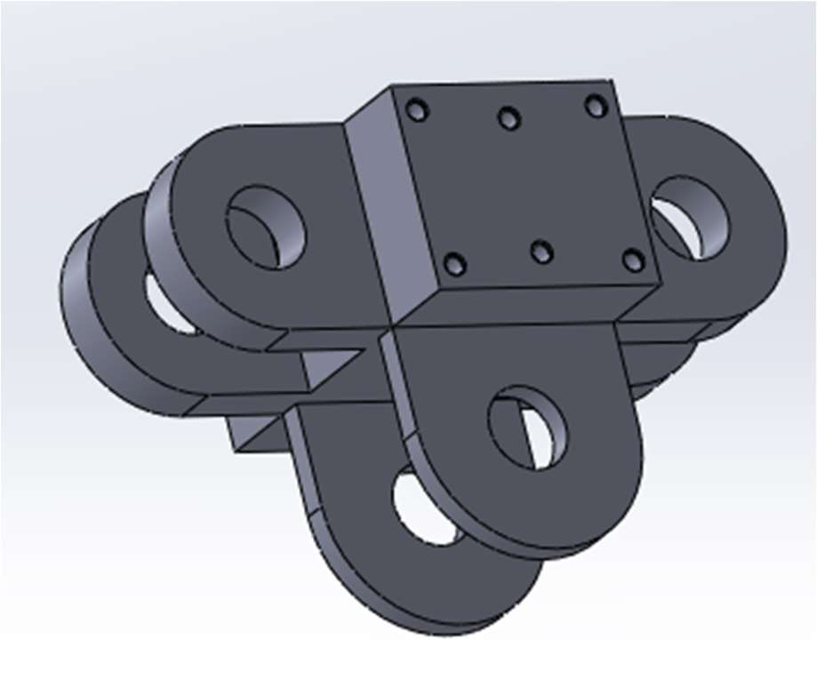
[picture p34: figure]

Rysunek 16 - blok

## 6 Załączniki

- PKR-JG_00.00
- PKR-JG_01.00
- PKR-JG_01.01
- PKR-JG_01.02
- PKR-JG_01.03
- PKR-JG_01.04
- PKR-JG_02.00
- PKR-JG_02.01
- PKR-JG_02.02
- PKR-JG_02.03
- PKR-JG_02.04
- PKR-JG_03.00
- PKR-JG_03.01
- PKR-JG_03.02
- PKR-JG_03.03
- PKR-JG_03.04
- Dokumentacja Siłownika
- Dokumentacja Prowadnicy HIWIN
