j-glow/chwytak/PDF/stelaz_ucho.pdf

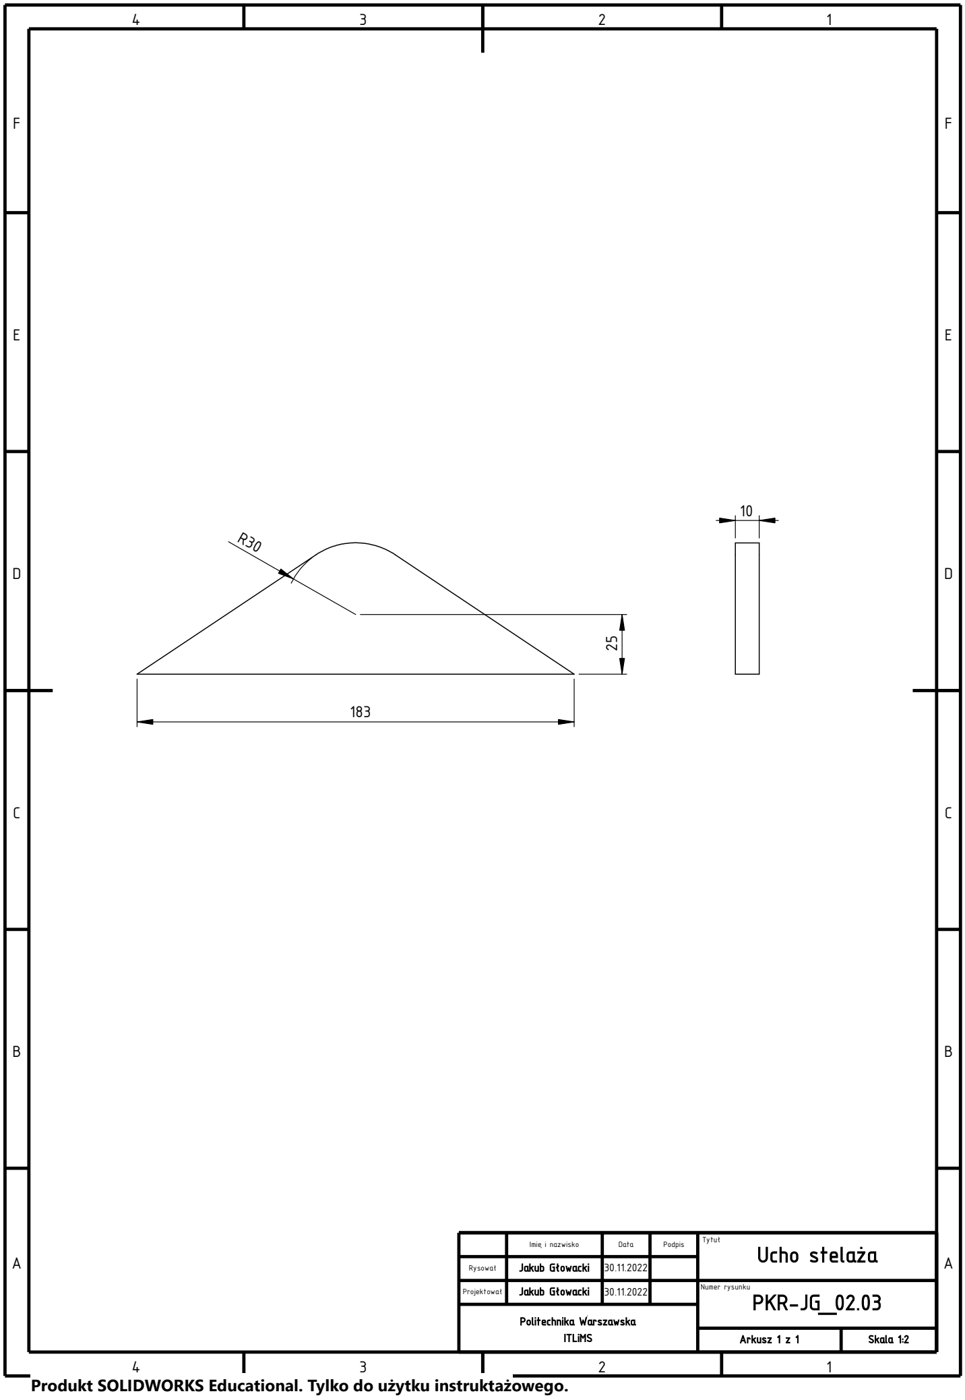
[picture p35: figure]
Numer rysunku; Rysował; Projektował; Tytuł Imię i nazwisko; Data; Podpis; Jakub Głowacki; Arkusz 1 z 1; Skala 1:2; PKR-JG_02.03; ITLiMS; Politechnika Warszawska; Ucho stelaża

Produkt SOLIDWORKS Educational. Tylko do użytku instruktażowego.
