j-glow/chwytak/PDF/stelaż_belkakrotka.pdf

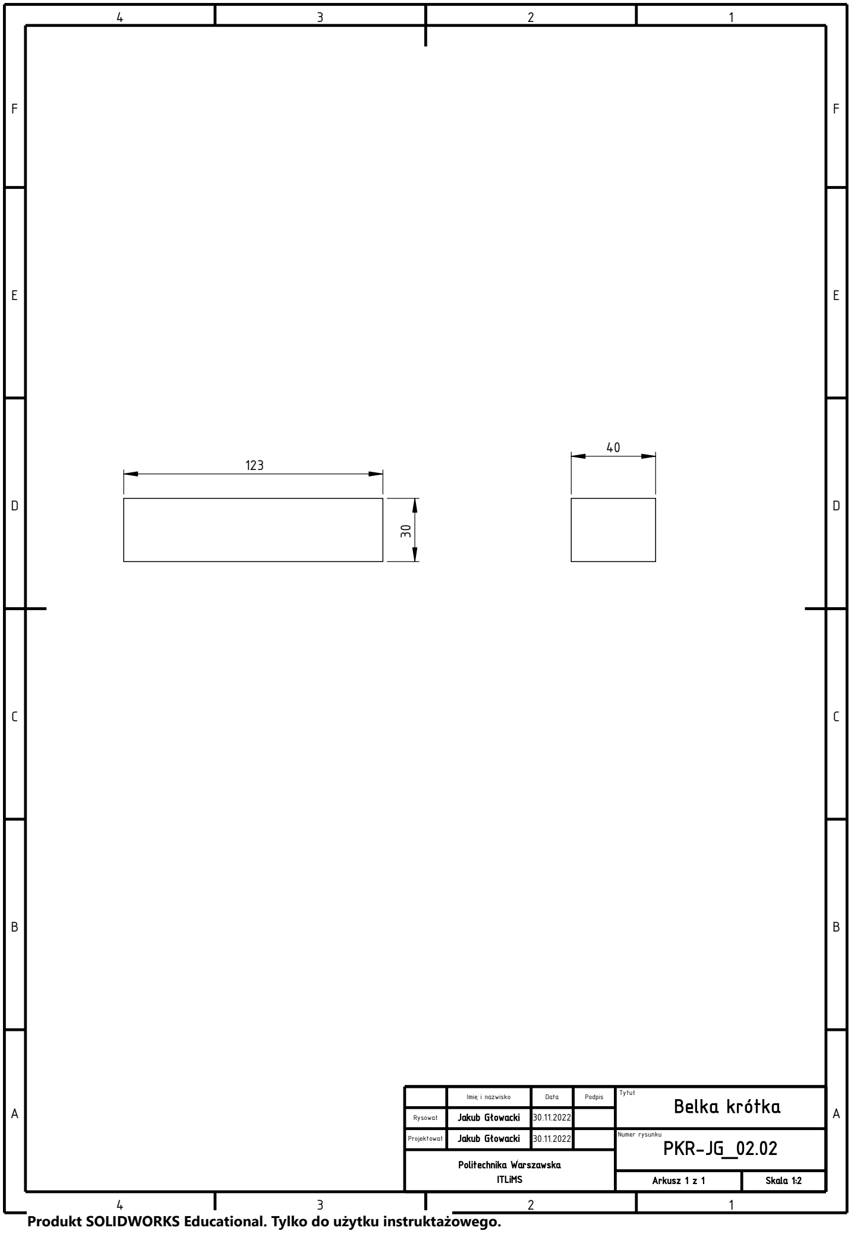
[picture p36: figure]
Numer rysunku; Rysował; Projektował; Tytuł Imię i nazwisko; Data; Podpis; Jakub Głowacki; Arkusz 1 z 1; Skala 1:2; PKR-JG_02.02; ITLiMS; Politechnika Warszawska; Belka krótka

Produkt SOLIDWORKS Educational. Tylko do użytku instruktażowego.
