j-glow/chwytak/zlozenie pelne.SLDASM

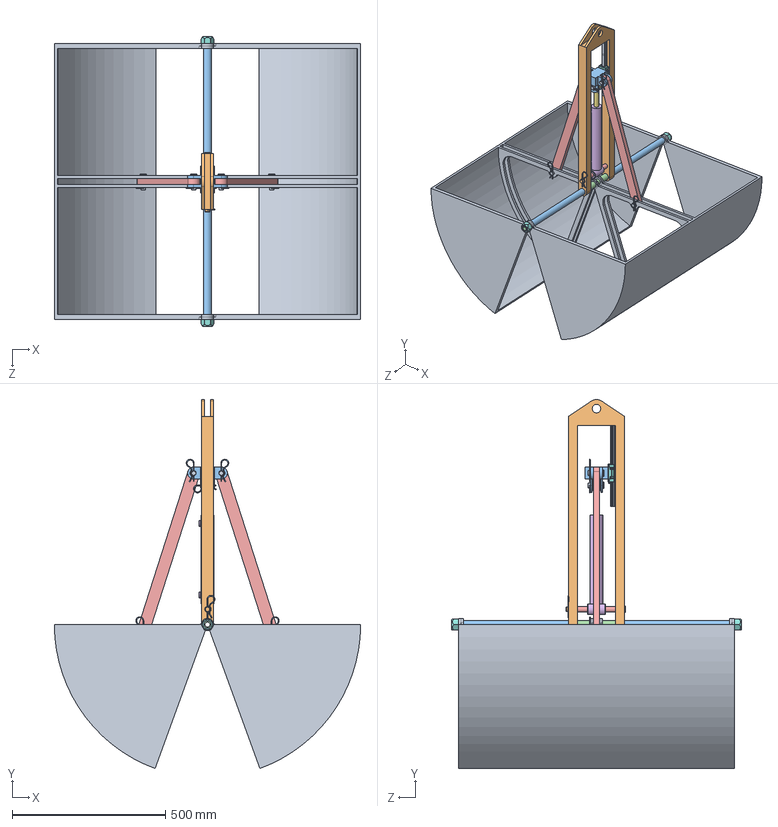
[picture p37: CAD file, 2023-01-25]
zlozenie pelne.SLDASM
1000.0 x 1204.6 x 948.0 mm
łyżka x 2
stelaz
blok
trzpień
ciegno x 2
c043220200_0_01
c043220200_0_02
wozek.stp
szyna.stp
slizg x 8
343,5 x 2
41,5 x 2
16.3x31,5 x 2
m4x12 x 6
m4x16 x 5
nakretka m24 din 985 x 2
16x40 x 5
16x200
zawleczka x 6
