j-glow/chwytak/modele3d/blok_spaw/blok_spaw.SLDASM

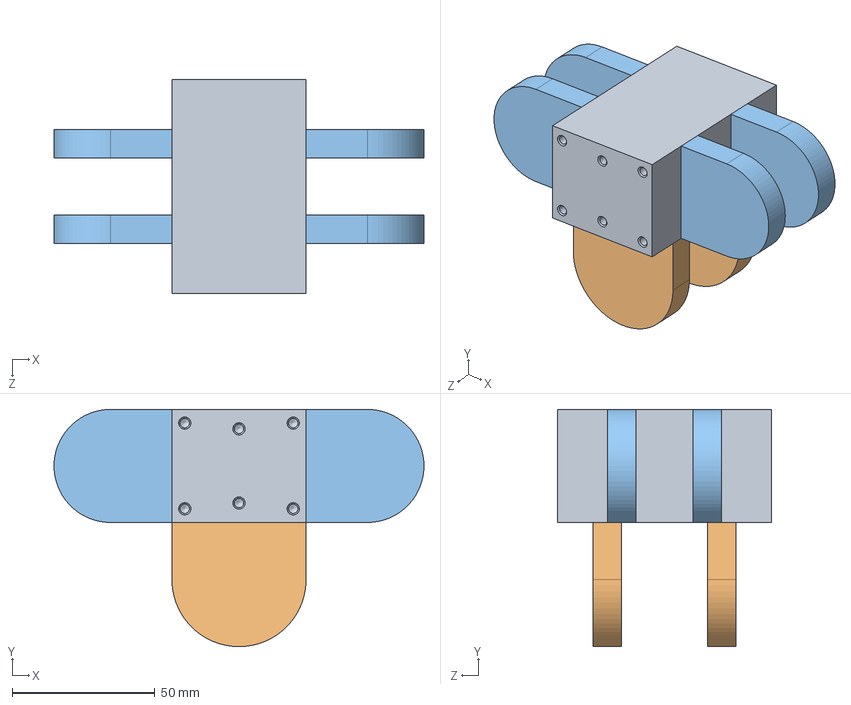
[picture p38: CAD file, 2023-01-25]
modele3d/blok_spaw/blok_spaw.SLDASM
129.6 x 83.1 x 75.0 mm
blok_bezuszu
ucho duze x 2
ucho male x 4
