j-glow/chwytak/modele3d/prowadnica/prowadnica.SLDASM

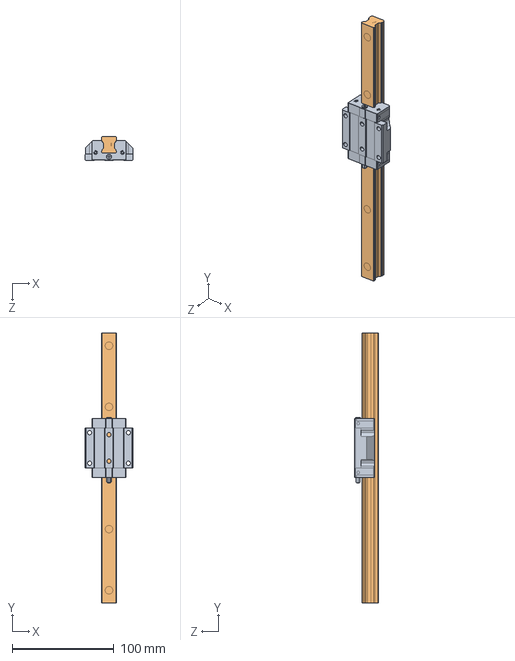
[picture p39: CAD file, 2023-01-25]
modele3d/prowadnica/prowadnica.SLDASM
47.0 x 265.0 x 24.0 mm
wozek.stp
szyna.stp
