j-glow/chwytak/modele3d/łyżka_spaw/lyzka spaw.SLDASM

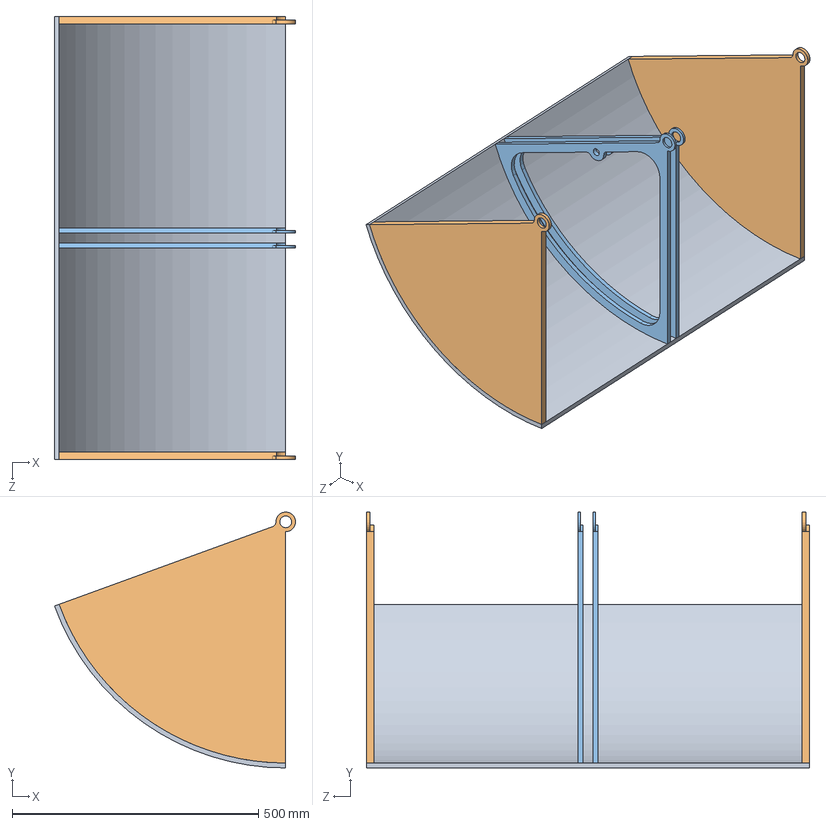
[picture p40: CAD file, 2023-01-25]
modele3d/łyżka_spaw/lyzka spaw.SLDASM
489.8 x 519.9 x 900.0 mm
skorupa
bok x 2
żebro x 2
