j-glow/chwytak/modele3d/silownik/silownik_ass.SLDASM

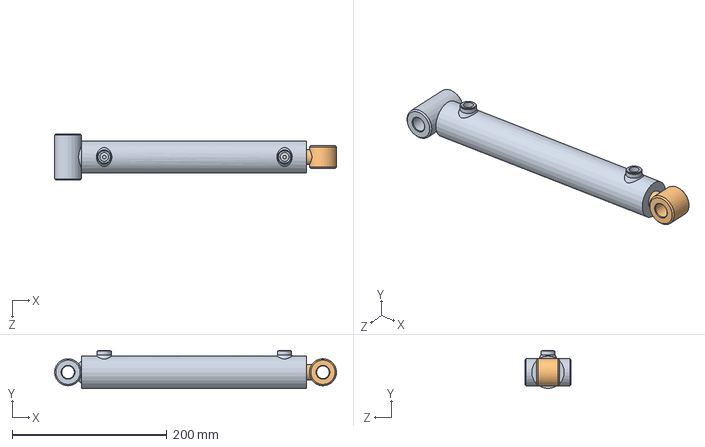
[picture p41: CAD file, 2023-01-25]
modele3d/silownik/silownik_ass.SLDASM
364.6 x 49.1 x 60.0 mm
c043220200_0_01
c043220200_0_02
