j-glow/chwytak/modele3d/stelaż spaw/stelaz spaw.SLDASM

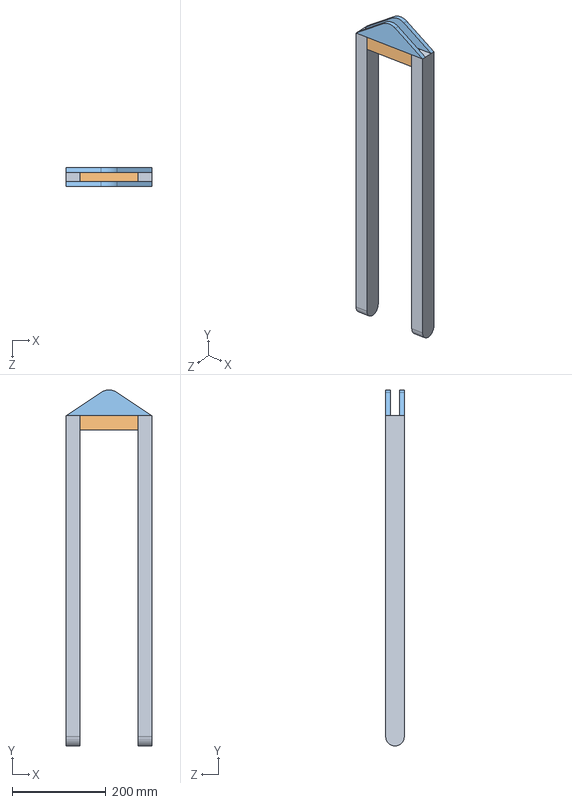
[picture p42: CAD file, 2023-01-25]
modele3d/stelaż spaw/stelaz spaw.SLDASM
183.0 x 759.9 x 40.0 mm
belka długa x 2
belka krótka
ucho stelaza x 2
