j-glow/chwytak/mes/blok/blok.SLDPRT

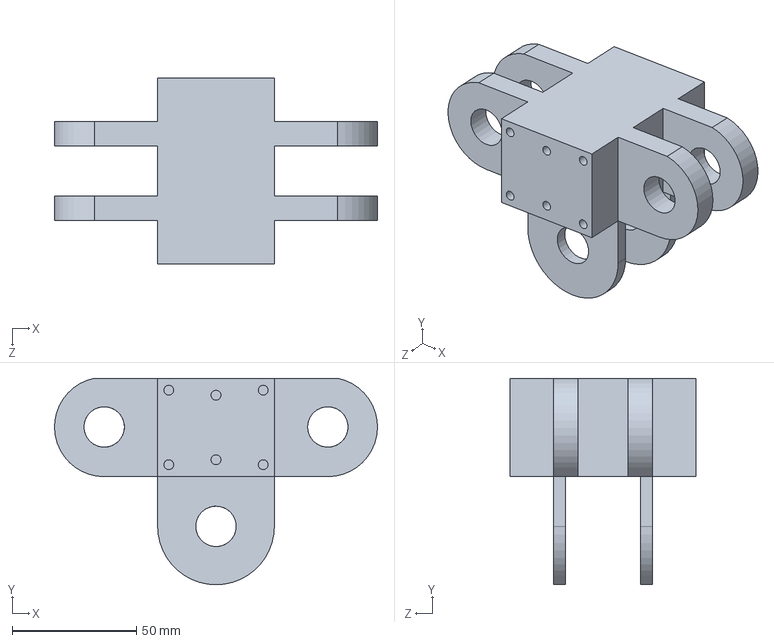
[picture p43: CAD file, 2023-01-25]
mes/blok/blok.SLDPRT
130.0 x 83.1 x 75.0 mm
