j-glow/chwytak/modele3d/blok_spaw/ucho male.SLDPRT

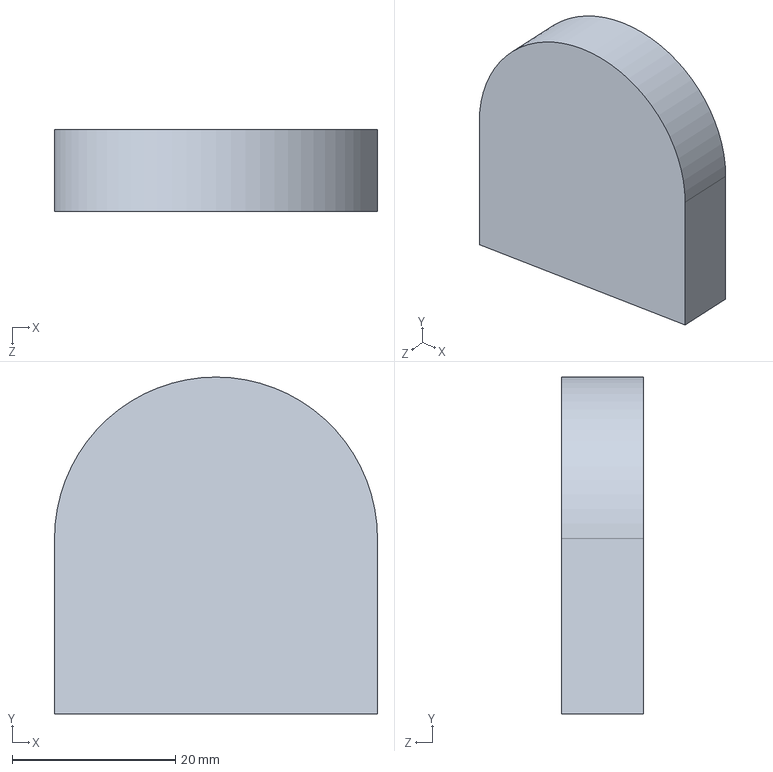
[picture p44: CAD file, 2023-01-25]
modele3d/blok_spaw/ucho male.SLDPRT
39.6 x 41.3 x 10.0 mm
