j-glow/chwytak/modele3d/prowadnica/wozek.stp.SLDPRT

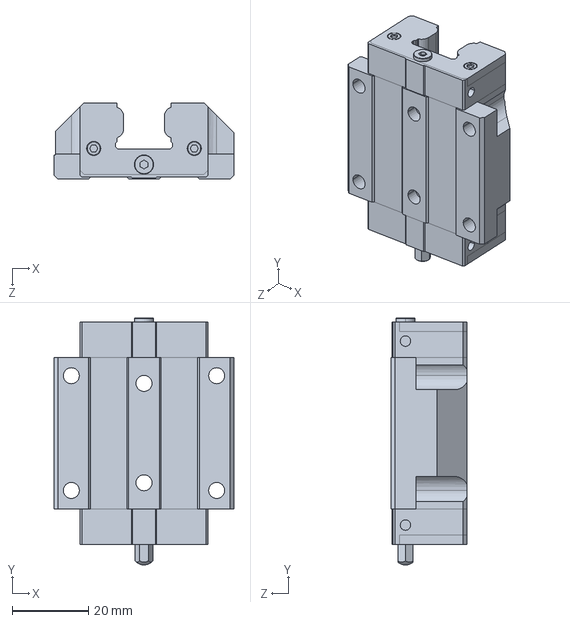
[picture p45: CAD file, 2023-01-25]
modele3d/prowadnica/wozek.stp.SLDPRT
47.0 x 64.6 x 19.9 mm
