j-glow/chwytak/modele3d/stelaz.SLDPRT

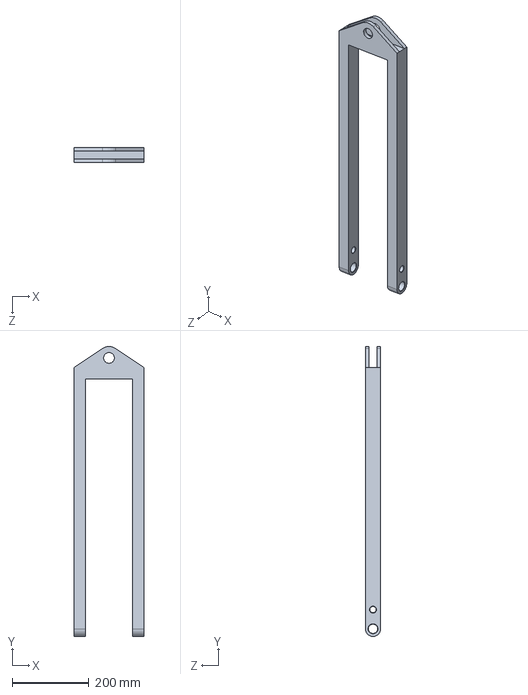
[picture p46: CAD file, 2023-01-25]
modele3d/stelaz.SLDPRT
183.0 x 754.8 x 40.0 mm
