j-glow/chwytak/modele3d/stelaż spaw/belka krótka.SLDPRT

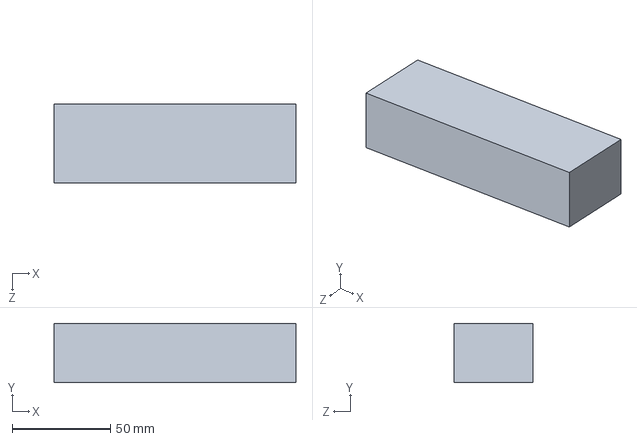
[picture p47: CAD file, 2023-01-25]
modele3d/stelaż spaw/belka krótka.SLDPRT
123.0 x 30.0 x 40.0 mm
