j-glow/chwytak/modele3d/sworznie/16x40.SLDPRT

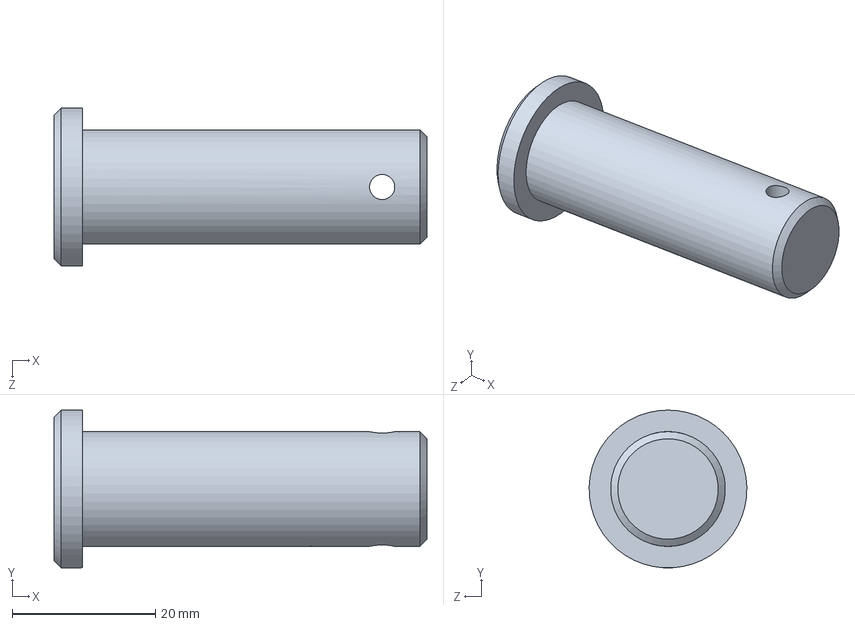
[picture p48: CAD file, 2023-01-25]
modele3d/sworznie/16x40.SLDPRT
52.0 x 22.0 x 22.0 mm
