j-glow/chwytak/modele3d/tuleje/41,5.SLDPRT

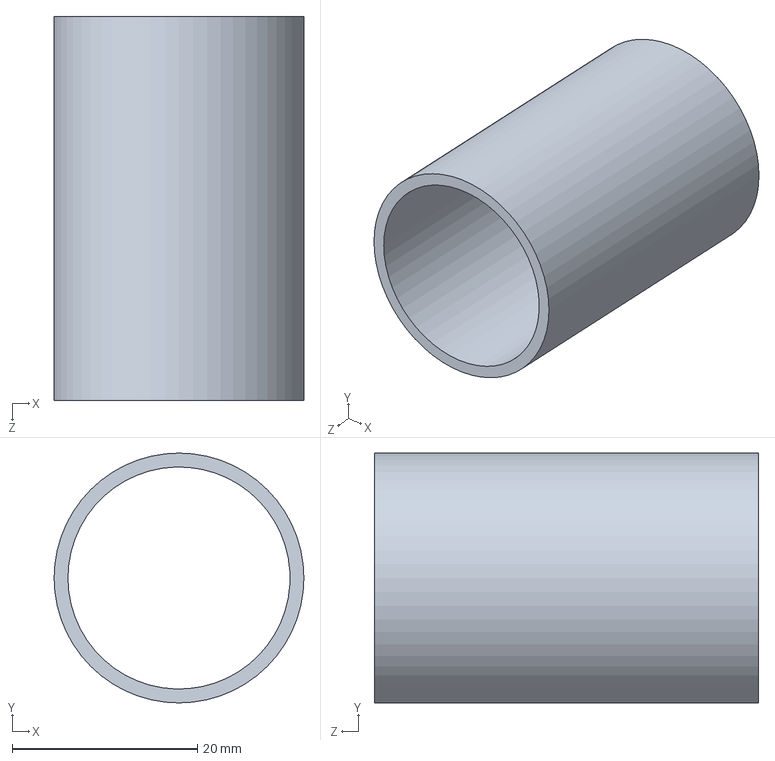
[picture p49: CAD file, 2023-01-25]
modele3d/tuleje/41,5.SLDPRT
27.0 x 27.0 x 41.5 mm
