j-glow/chwytak/modele3d/łyżka_spaw/skorupa.SLDPRT

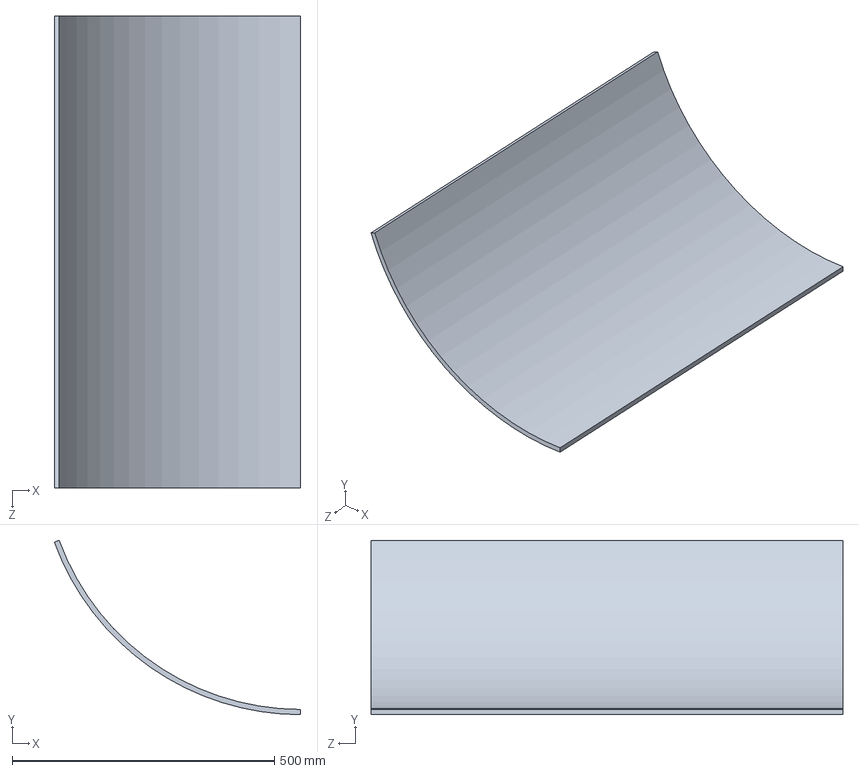
[picture p50: CAD file, 2023-01-25]
modele3d/łyżka_spaw/skorupa.SLDPRT
469.8 x 332.4 x 900.0 mm
