j-glow/chwytak/modele3d/stelaż spaw/ucho stelaza.SLDPRT

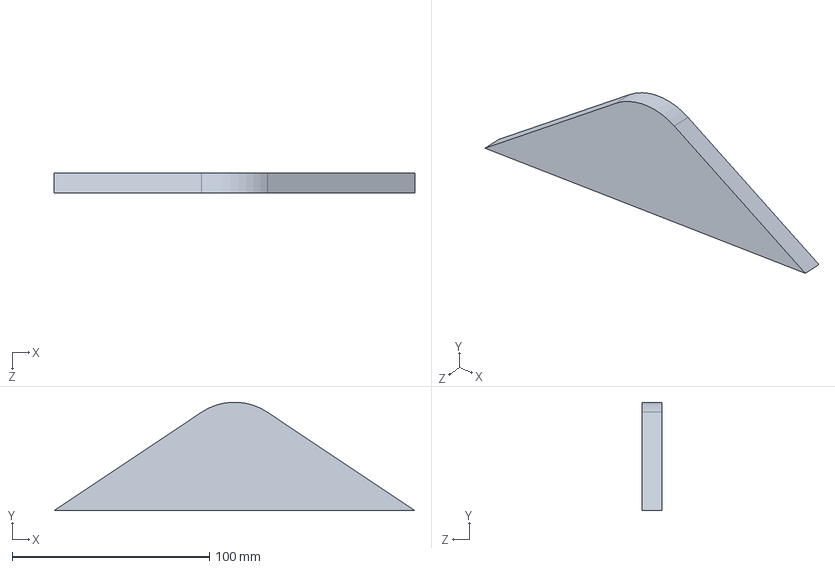
[picture p51: CAD file, 2023-01-25]
modele3d/stelaż spaw/ucho stelaza.SLDPRT
183.0 x 54.9 x 10.0 mm
