j-glow/chwytak/modele3d/sworznie/16x200.SLDPRT

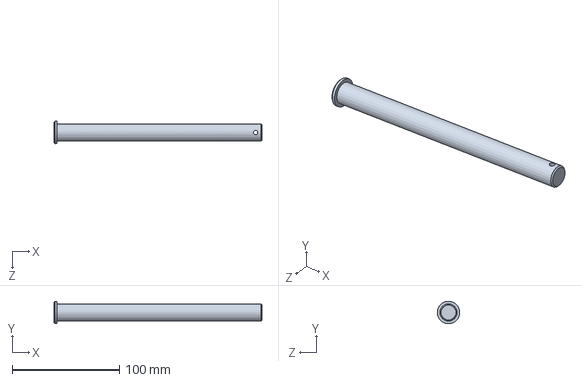
[picture p52: CAD file, 2023-01-25]
modele3d/sworznie/16x200.SLDPRT
194.0 x 21.0 x 21.0 mm
