j-glow/chwytak/modele3d/tuleje/16.3x31,5.SLDPRT

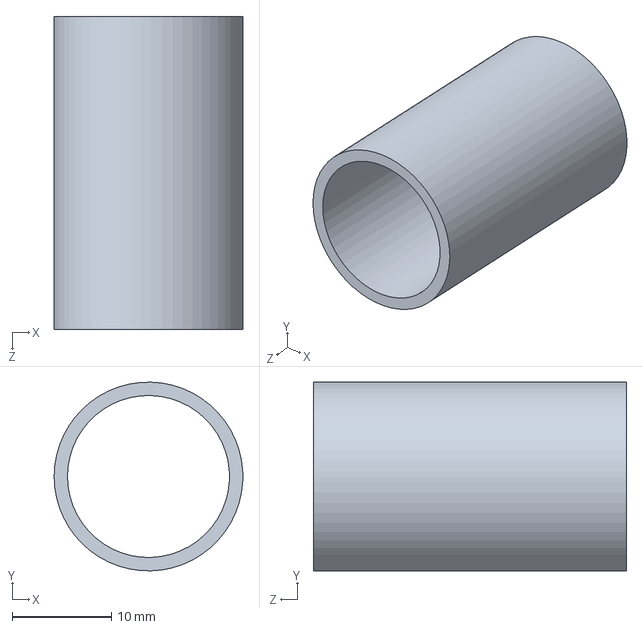
[picture p53: CAD file, 2023-01-25]
modele3d/tuleje/16.3x31,5.SLDPRT
19.0 x 19.0 x 31.5 mm
