j-glow/chwytak/modele3d/blok_spaw/blok_bezuszu.SLDPRT

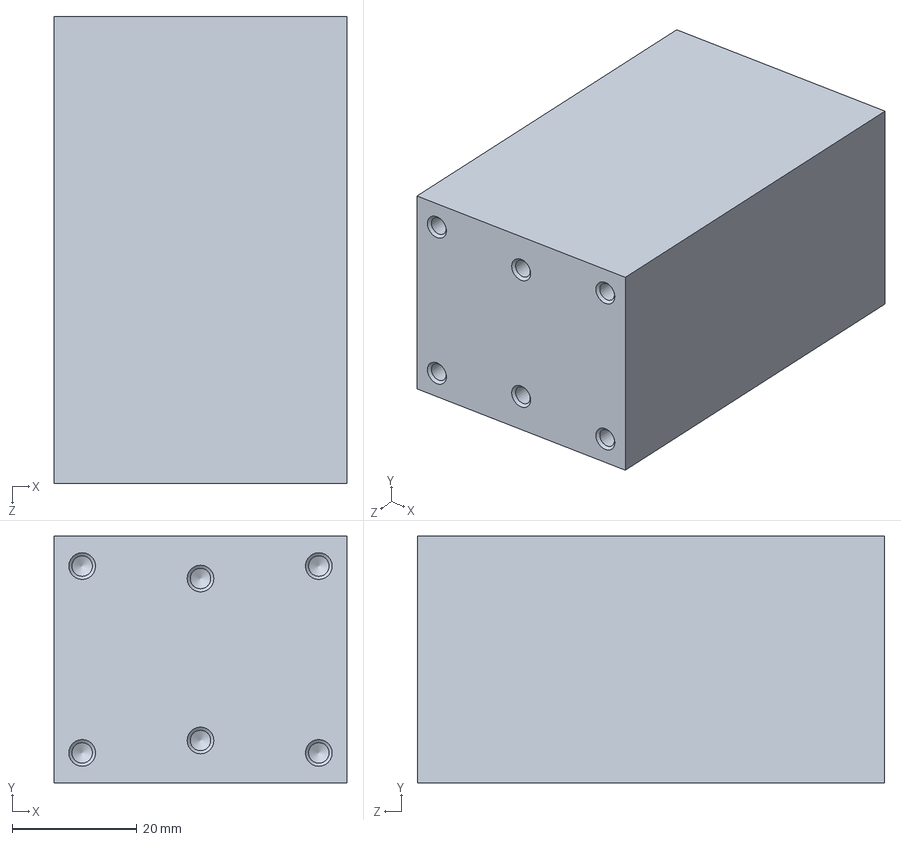
[picture p54: CAD file, 2023-01-25]
modele3d/blok_spaw/blok_bezuszu.SLDPRT
47.0 x 39.6 x 75.0 mm
