j-glow/chwytak/modele3d/nakretka m24 din 985.SLDPRT

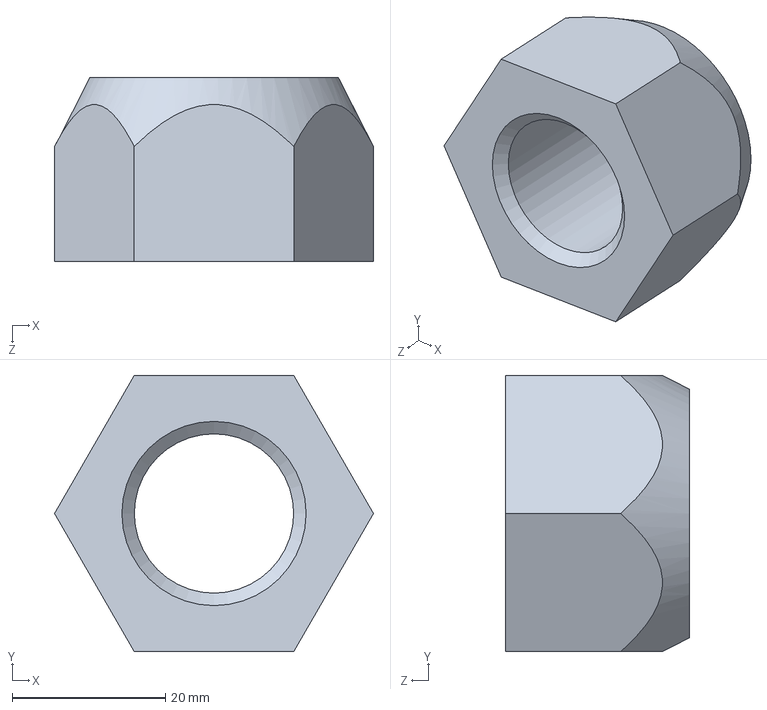
[picture p55: CAD file, 2023-01-25]
modele3d/nakretka m24 din 985.SLDPRT
41.6 x 36.0 x 24.0 mm
