j-glow/chwytak/modele3d/prowadnica/szyna.stp.SLDPRT

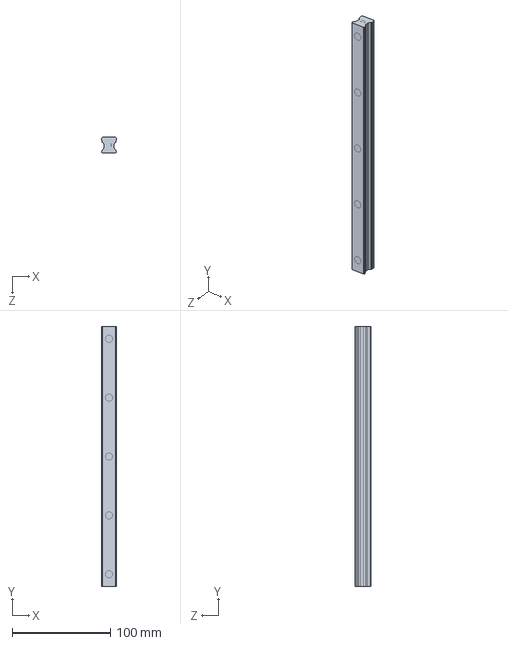
[picture p56: CAD file, 2023-01-25]
modele3d/prowadnica/szyna.stp.SLDPRT
15.0 x 265.0 x 16.2 mm
