j-glow/chwytak/modele3d/stelaż spaw/belka długa.SLDPRT

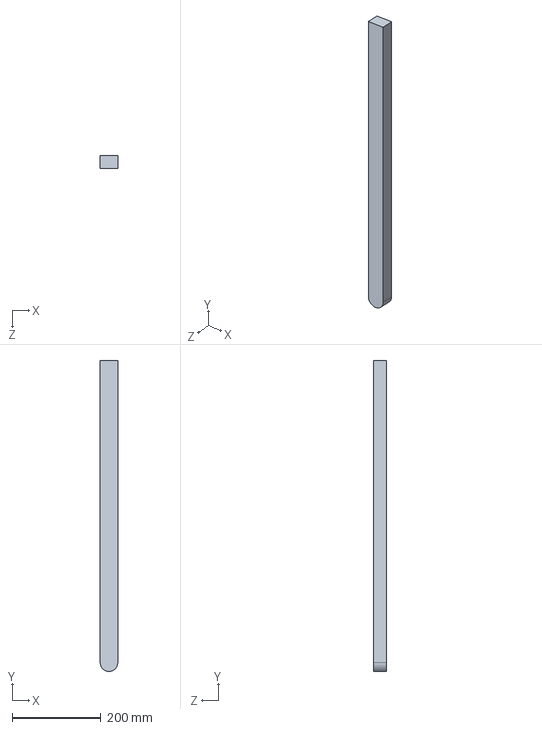
[picture p57: CAD file, 2023-01-25]
modele3d/stelaż spaw/belka długa.SLDPRT
40.0 x 700.0 x 30.0 mm
