j-glow/chwytak/modele3d/sworznie/16x50.SLDPRT

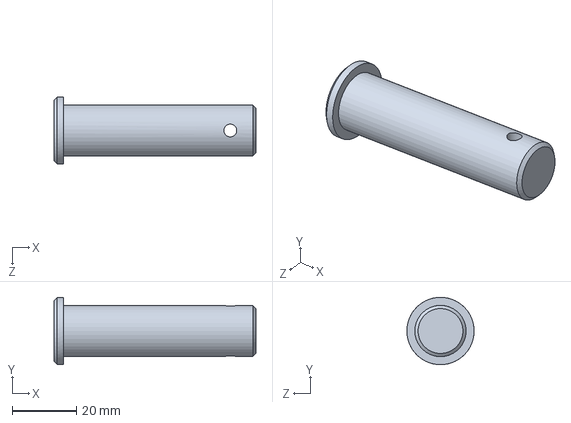
[picture p58: CAD file, 2023-01-25]
modele3d/sworznie/16x50.SLDPRT
63.0 x 21.0 x 21.0 mm
