j-glow/chwytak/modele3d/tuleje/slizg.SLDPRT

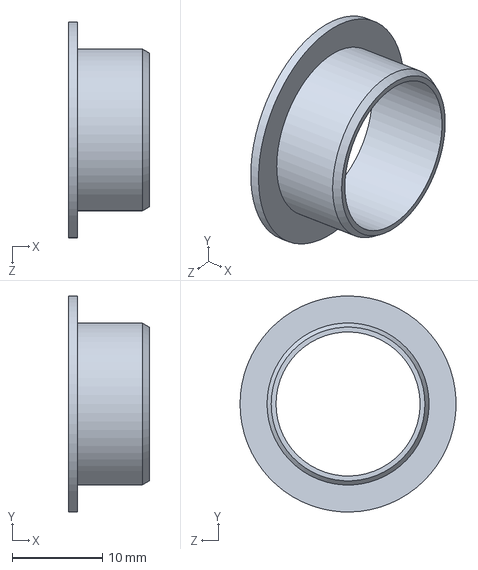
[picture p59: CAD file, 2023-01-25]
modele3d/tuleje/slizg.SLDPRT
9.00 x 24.0 x 24.0 mm
