j-glow/chwytak/modele3d/łyżka_spaw/żebro.SLDPRT

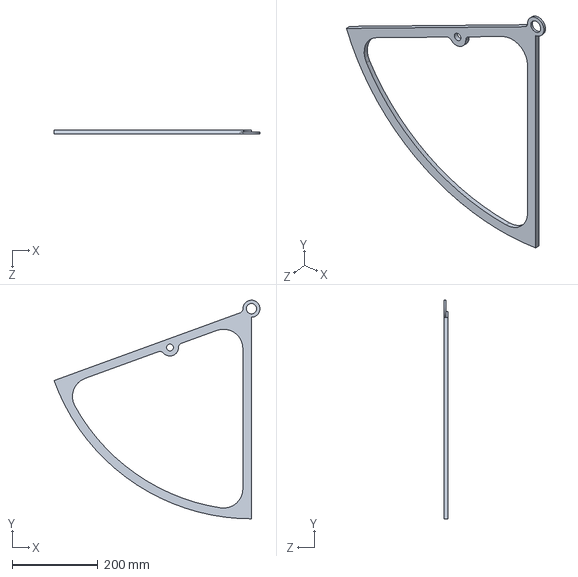
[picture p60: CAD file, 2023-01-25]
modele3d/łyżka_spaw/żebro.SLDPRT
480.4 x 509.9 x 10.0 mm
