j-glow/chwytak/modele3d/blok_spaw/ucho duze.SLDPRT

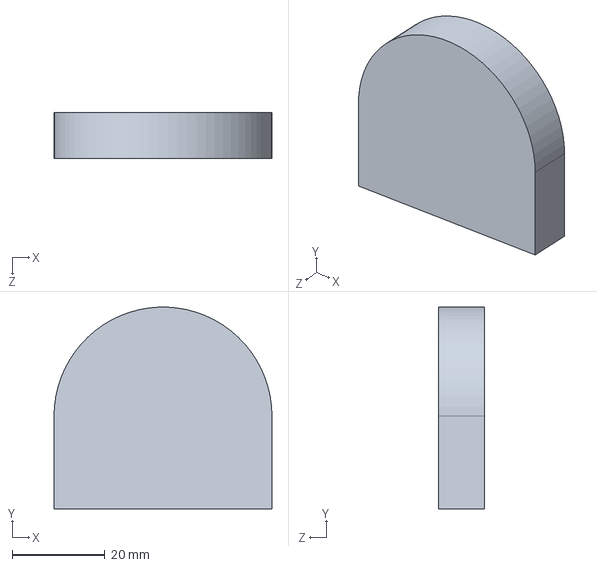
[picture p61: CAD file, 2023-01-25]
modele3d/blok_spaw/ucho duze.SLDPRT
47.0 x 43.5 x 10.0 mm
