j-glow/chwytak/modele3d/sworznie/zawleczka.SLDPRT

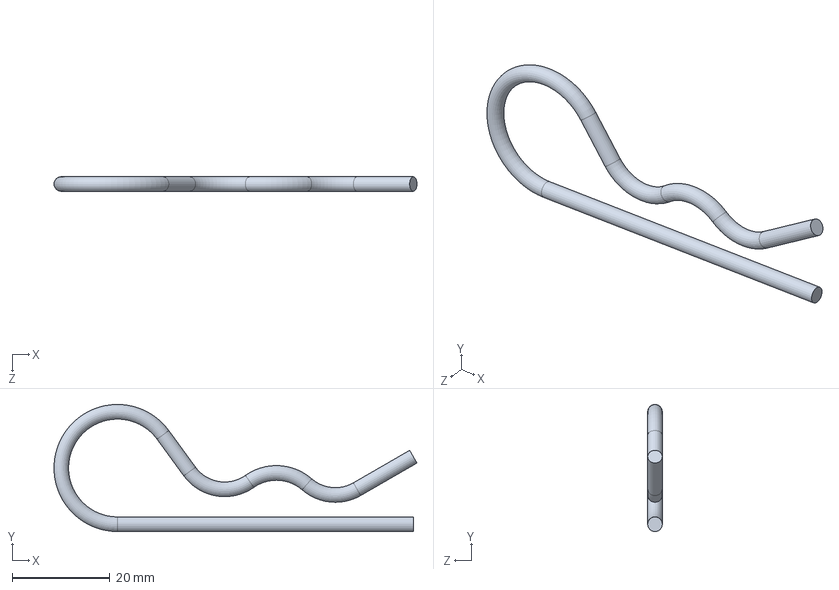
[picture p62: CAD file, 2023-01-25]
modele3d/sworznie/zawleczka.SLDPRT
74.2 x 26.0 x 3.00 mm
