j-glow/chwytak/modele3d/tuleje/343,5.SLDPRT

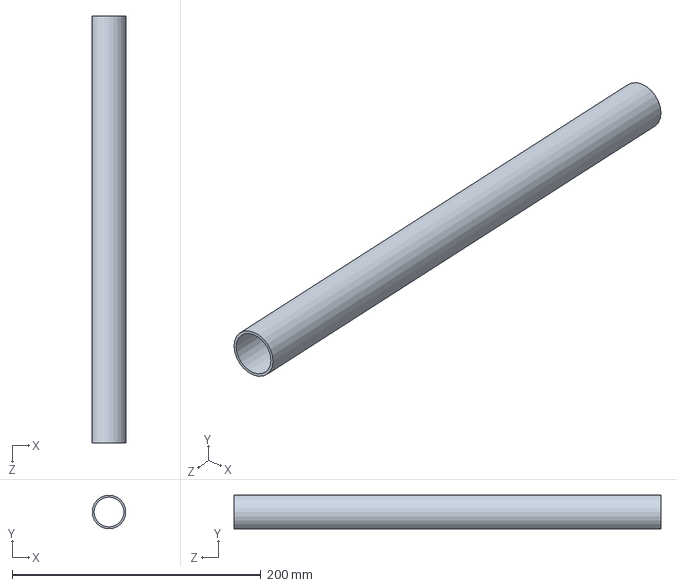
[picture p63: CAD file, 2023-01-25]
modele3d/tuleje/343,5.SLDPRT
27.0 x 27.0 x 343.5 mm
