j-glow/chwytak/modele3d/łyżka_spaw/bok.SLDPRT

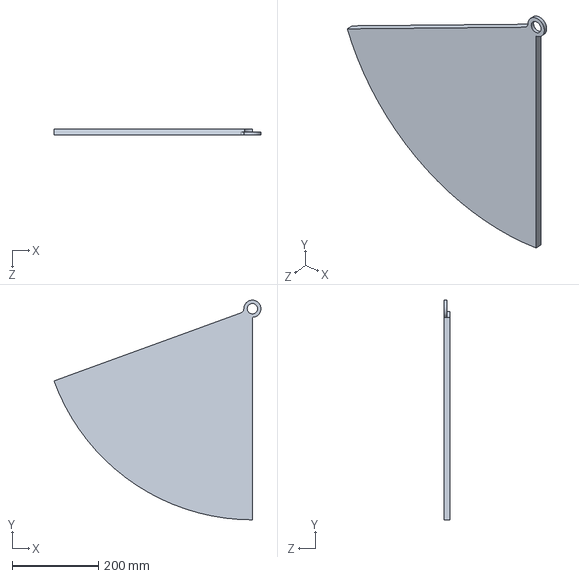
[picture p64: CAD file, 2023-01-25]
modele3d/łyżka_spaw/bok.SLDPRT
480.4 x 509.9 x 15.0 mm
