j-glow/chwytak/modele3d/ciegno.SLDPRT

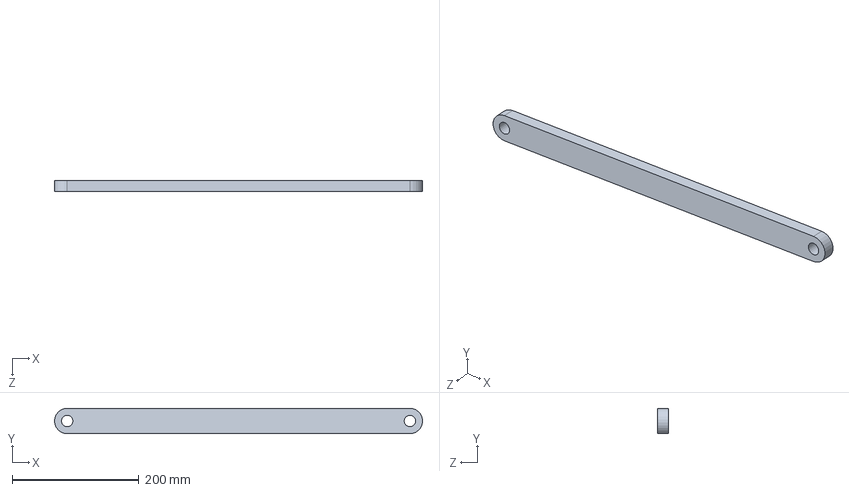
[picture p65: CAD file, 2023-01-25]
modele3d/ciegno.SLDPRT
579.9 x 40.0 x 18.0 mm
