j-glow/chwytak/modele3d/blok.SLDPRT

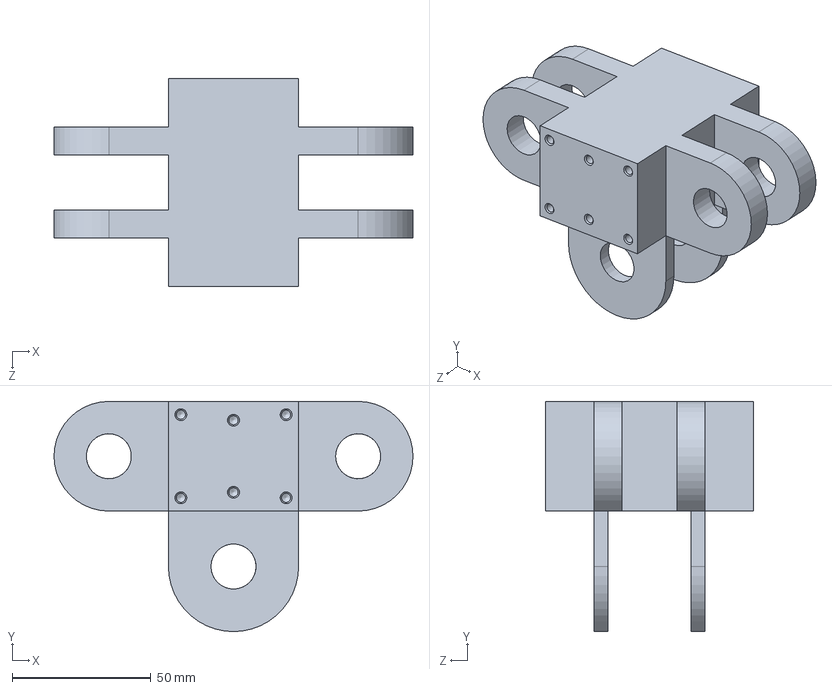
[picture p66: CAD file, 2023-01-25]
modele3d/blok.SLDPRT
129.6 x 83.1 x 75.0 mm
