j-glow/chwytak/modele3d/trzpień.SLDPRT

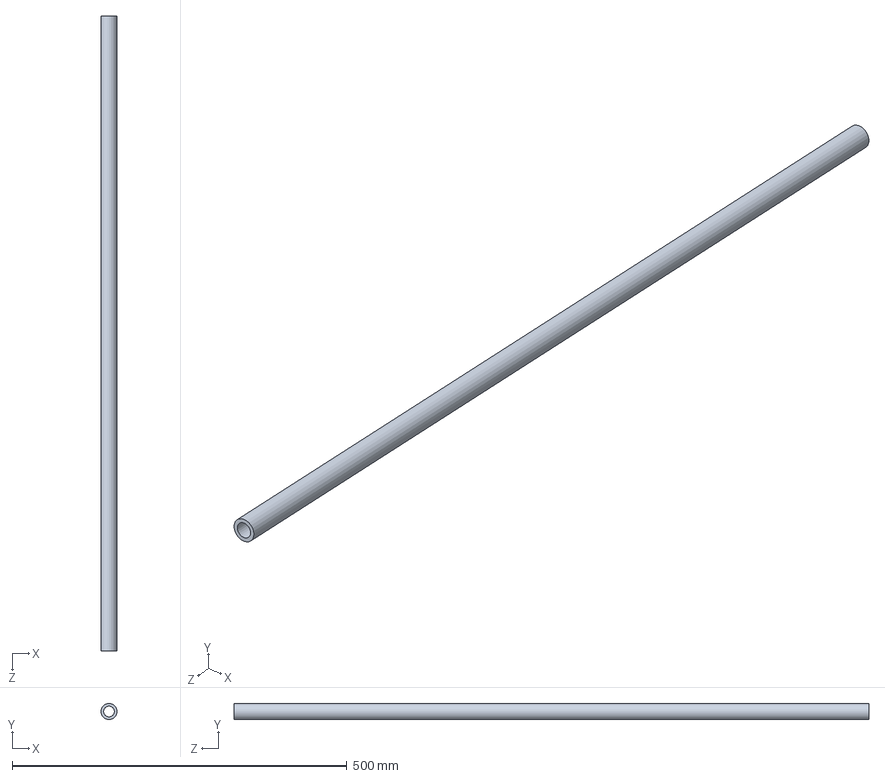
[picture p67: CAD file, 2023-01-25]
modele3d/trzpień.SLDPRT
24.0 x 24.0 x 948.0 mm
