j-glow/chwytak/(list of files, cad)

Other CAD files:
mes/łyżka/łyżka.SLDPRT
modele3d/schemat_kin.SLDPRT
modele3d/łyżka.SLDPRT
modele3d/blok.SLDDRW
modele3d/blok_spaw/blok_bezuszu.SLDDRW
modele3d/blok_spaw/blok_spaw.SLDDRW
modele3d/blok_spaw/ucho duze.SLDDRW
modele3d/blok_spaw/ucho male.SLDDRW
modele3d/formatka a4.SLDDRW
modele3d/lyzka.SLDDRW
modele3d/silownik/c043220200_0_01.SLDPRT
modele3d/silownik/c043220200_0_02.SLDPRT
modele3d/srudy din 912/m4x12.SLDPRT
modele3d/srudy din 912/m4x16.SLDPRT
modele3d/stelaz.SLDDRW
modele3d/stelaż spaw/belka długa.SLDDRW
modele3d/stelaż spaw/belka krótka.SLDDRW
modele3d/stelaż spaw/stelaz spaw.SLDDRW
modele3d/stelaż spaw/ucho stelaza.SLDDRW
modele3d/łyżka_spaw/bok.SLDDRW
modele3d/łyżka_spaw/lyzka spaw.SLDDRW
modele3d/łyżka_spaw/skorupa.SLDDRW
modele3d/łyżka_spaw/żebro.SLDDRW
zlozenie pelne.SLDDRW
zlozenie_dwg.SLDDRW
