j-glow/chwytak/PDF/A2_rysunekzlozenie.pdf

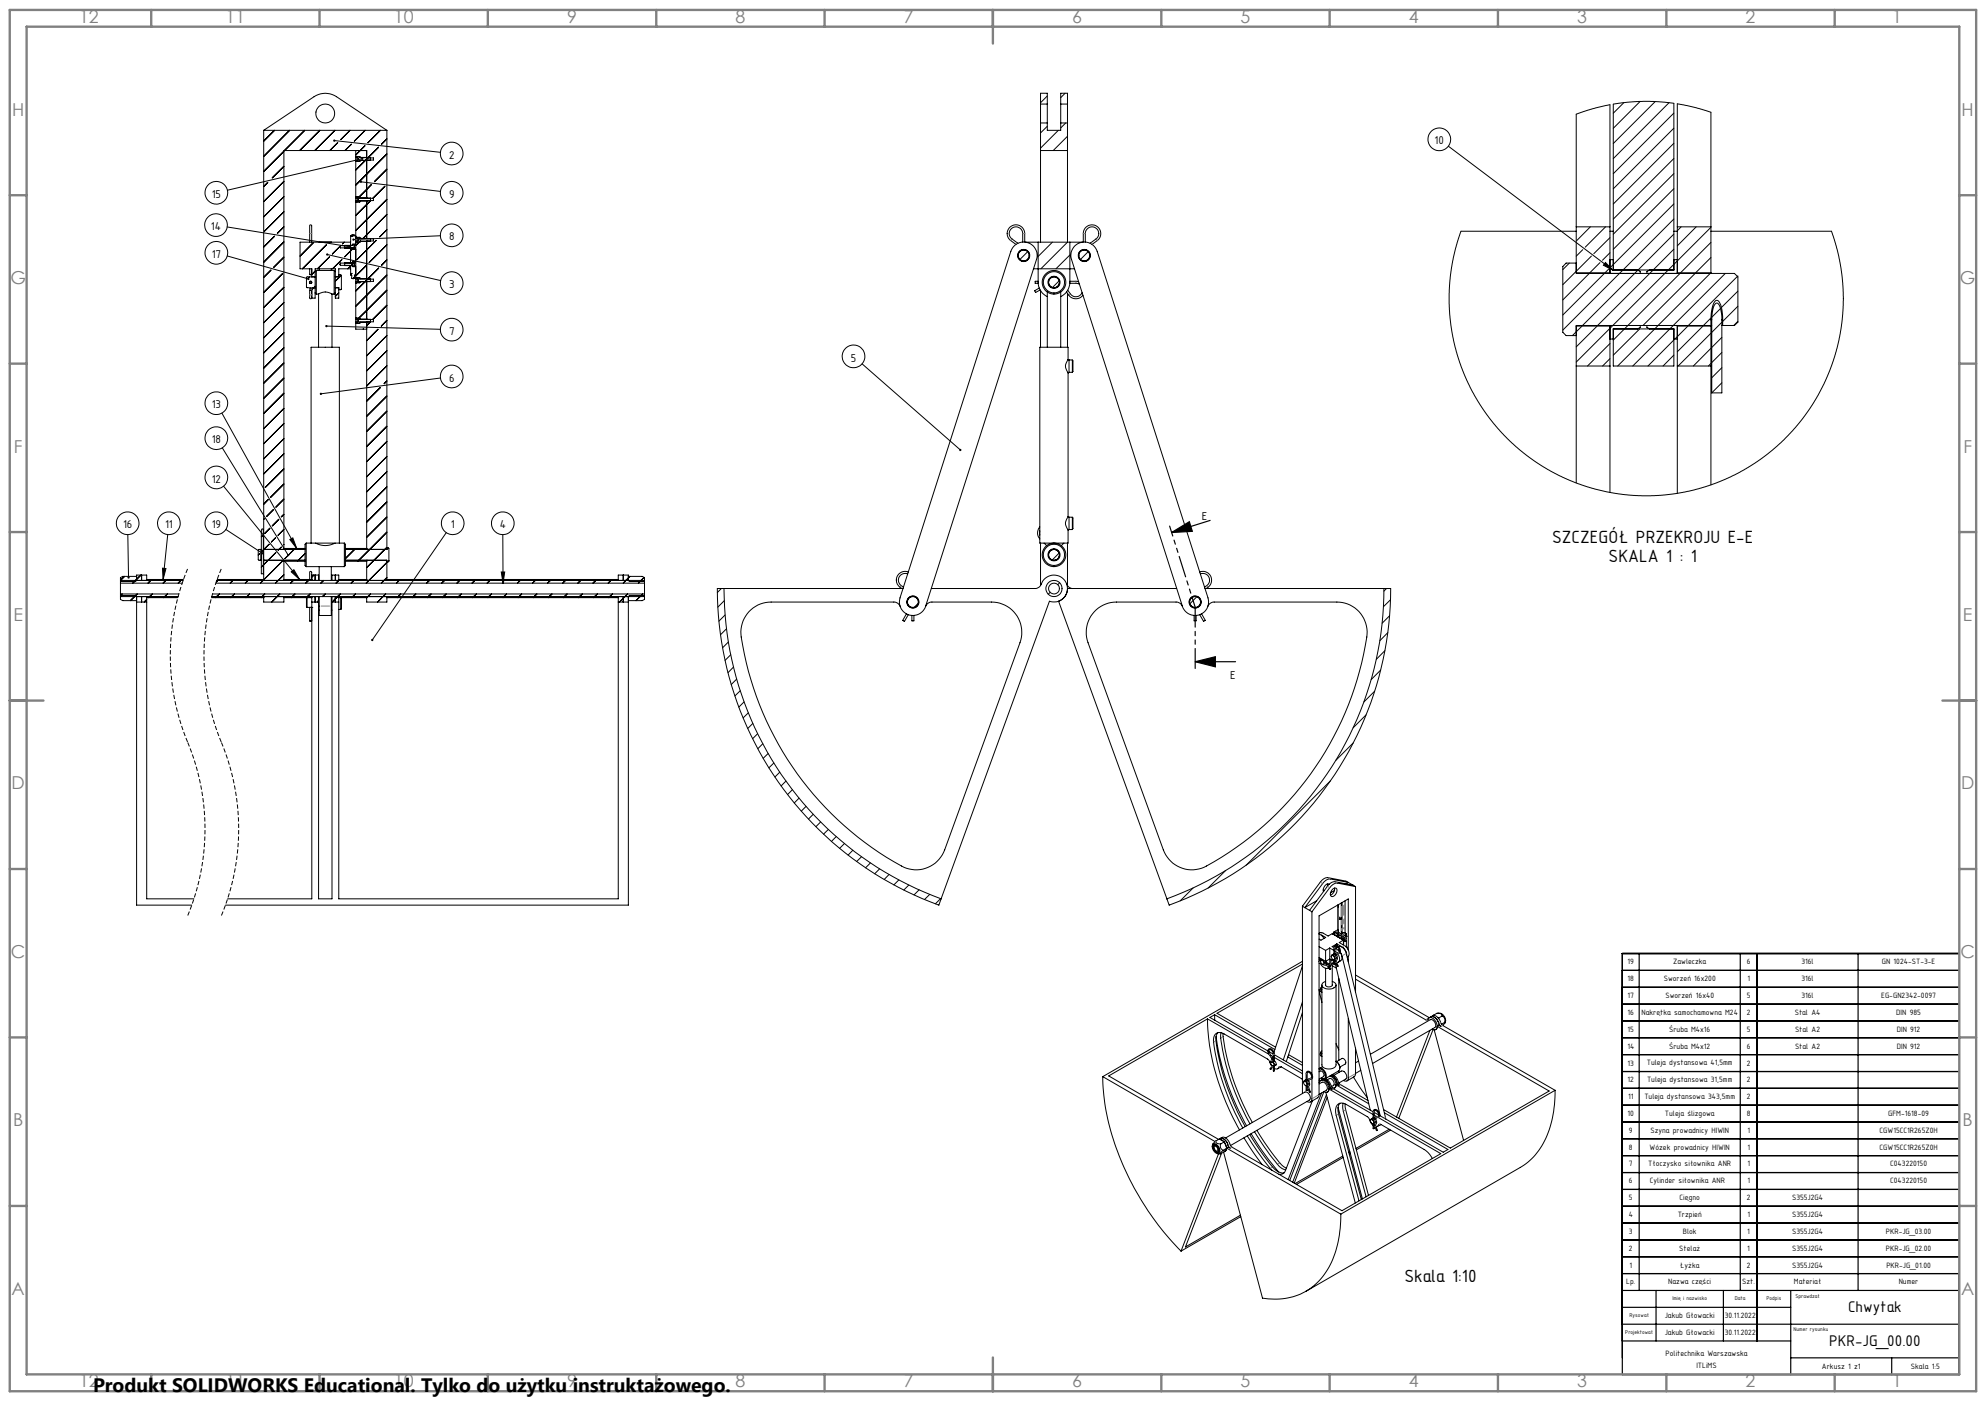
[picture p68: page 1]
Skala 1:10; SZCZEGÓŁ PRZEKROJU E-E SKALA 1 : 1; Stal A2; DIN 912; Śruba M4x12; Politechnika Warszawska; Arkusz 1 z1; Skala 1:5

19 | Zawleczka | 6 | 316l | GN 1024-ST-3-E
18 | Sworzeń 16x200 | 1 | 316l
17 | Sworzeń 16x40 | 5 | 316l | EG-GN2342-0097
16 | Nakrętka samochamowna M24 | 2 | Stal A4 | DIN 985
15 | Śruba M4x16 | 5 | Stal A2 | DIN 912

13 | Tuleja dystansowa 41,5mm | 2
12 | Tuleja dystansowa 31,5mm | 2
11 | Tuleja dystansowa 343,5mm | 2
10 | Tuleja ślizgowa | 8 | | GFM-1618-09
9 | Szyna prowadnicy HIWIN | 1 | | CGW15CC1R265Z0H
8 | Wózek prowadnicy HIWIN | 1 | | CGW15CC1R265Z0H
7 | Tłoczysko siłownika ANR | 1 | | C043220150
6 | Cylinder siłownika ANR | 1 | | C043220150
5 | Cięgno | 2 | S355J2G4
4 | Trzpień | 1 | S355J2G4
3 | Blok | 1 | S355J2G4 | PKR-JG_03.00
2 | Stelaż | 1 | S355J2G4 | PKR-JG_02.00
1 | Łyżka | 2 | S355J2G4 | PKR-JG_01.00
Lp. | Nazwa części | Szt. | Materiał | Numer
Imię i nazwisko | Data | Podpis | Sprawdzał Chwytak

Rysował | Jakub Głowacki | 30.11.2022
Projektował | | 30.11.2022 | | Numer rysunku

PKR-JG_00.00 Jakub Głowacki

Produkt SOLIDWORKS Educational. Tylko do użytku instruktażowego.
