j-glow/chwytak/PDF/lyzka_skorupa.pdf

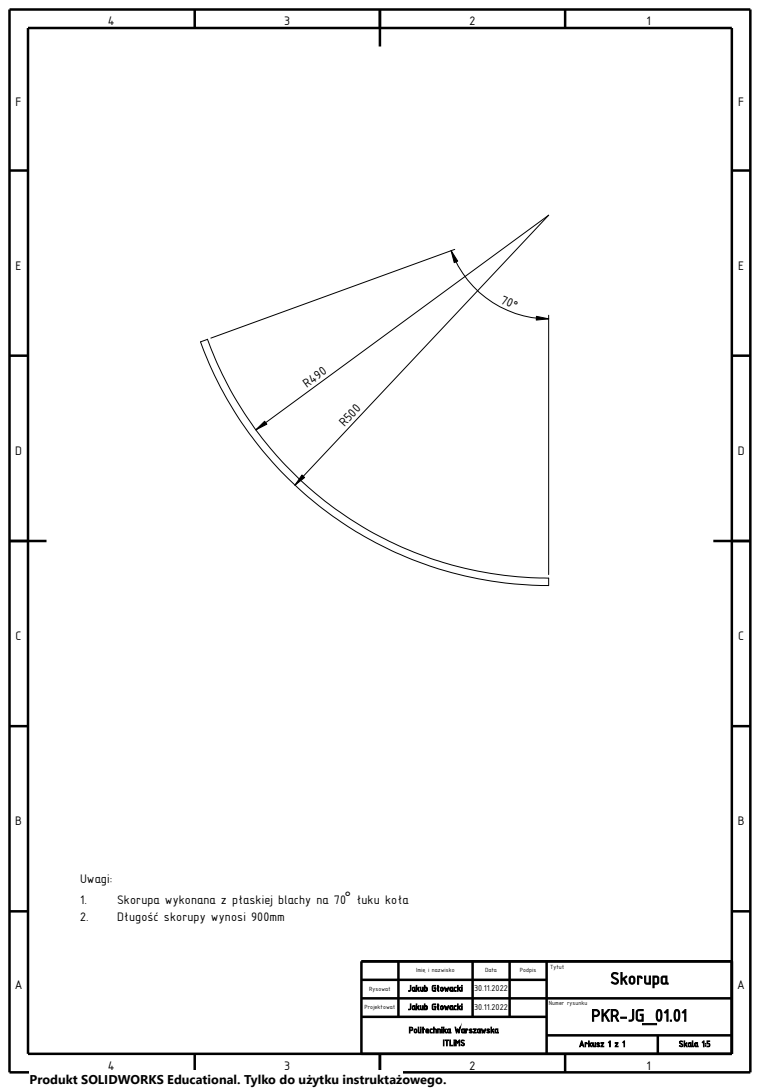
[picture p69: page 1]
Numer rysunku; Rysował; Projektował; Tytuł Imię i nazwisko; Data; Podpis; Jakub Głowacki; Arkusz 1 z 1; Skala 1:5; PKR-JG_01.01; ITLiMS; Politechnika Warszawska; Skorupa

Uwagi:
1. Skorupa wykonana z płaskiej blachy na 70° łuku koła
2. Długość skorupy wynosi 900mm

Produkt SOLIDWORKS Educational. Tylko do użytku instruktażowego.
