j-glow/chwytak/PDF/blok_spaw.pdf

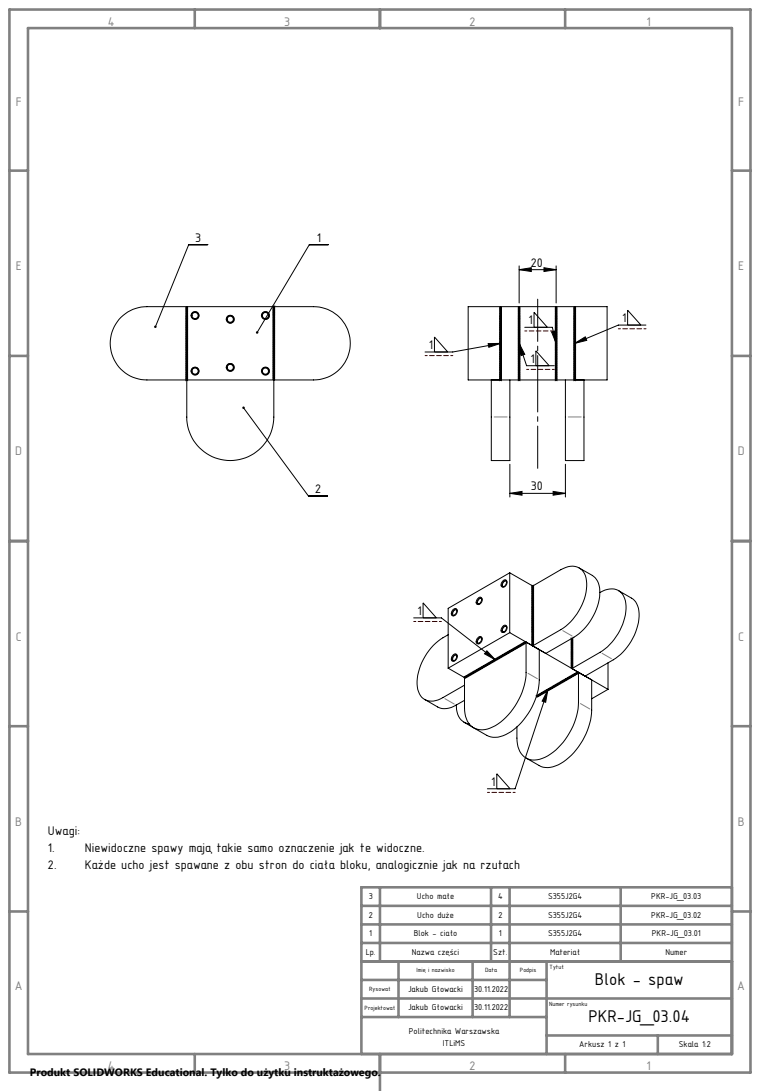
[picture p70: page 1]
Arkusz 1 z 1; Skala 1:2; Politechnika Warszawska

Uwagi:
1. Niewidoczne spawy mają takie samo oznaczenie jak te widoczne.
2. Każde ucho jest spawane z obu stron do ciała bloku, analogicznie jak na rzutach

3 | Ucho małe | 4 | S355J2G4 | PKR-JG_03.03
2 | Ucho duże | 2 | S355J2G4 | PKR-JG_03.02
1 | Blok - ciało | 1 | S355J2G4 | PKR-JG_03.01
Lp. | Nazwa części | Szt. | Materiał | Numer

Data | Podpis | Tytuł Imię i nazwisko Blok - spaw

Rysował | Jakub Głowacki | 30.11.2022

Projektował | Jakub Głowacki | 30.11.2022 | | PKR-JG_03.04 Numer rysunku

Produkt SOLIDWORKS Educational. Tylko do użytku instruktażowego.
