j-glow/chwytak/PDF/blok_trzon.pdf

E E

F F

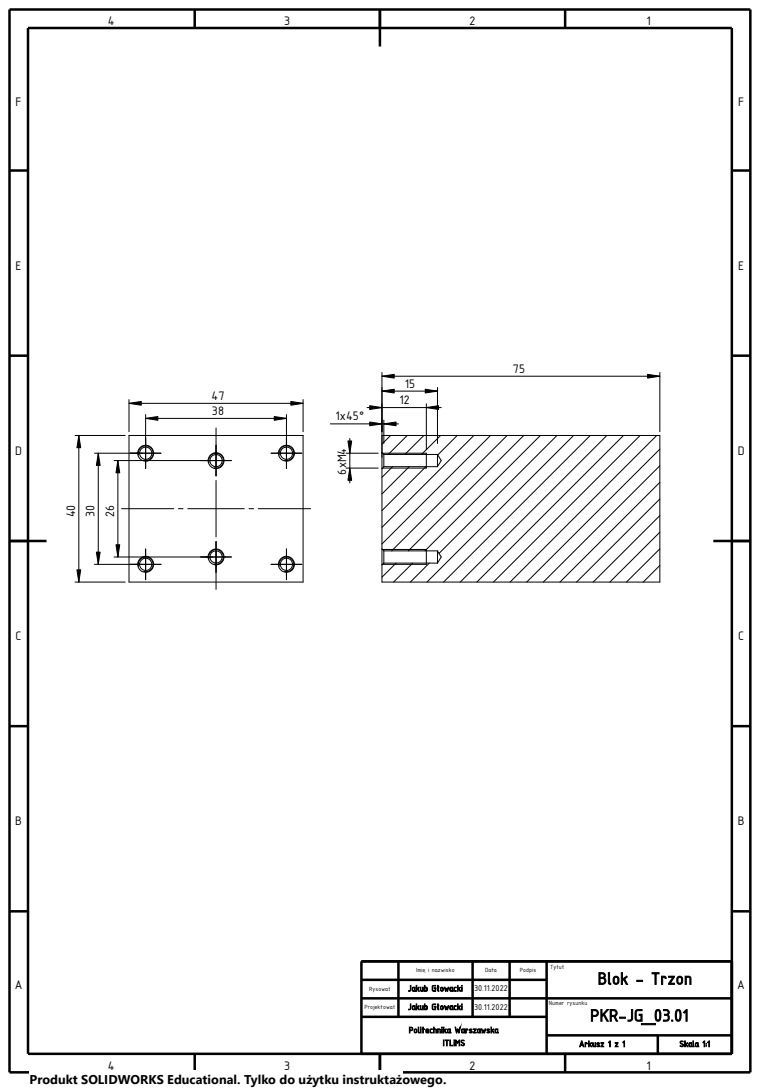
[picture p71: page 1]
Numer rysunku; Rysował; Projektował; Tytuł Imię i nazwisko; Data; Podpis; Jakub Głowacki; Arkusz 1 z 1; Skala 1:1; PKR-JG_03.01; ITLiMS; Politechnika Warszawska; Blok - Trzon; 15 6xM⁴

Produkt SOLIDWORKS Educational. Tylko do użytku instruktażowego.
