j-glow/chwytak/PDF/blok_uchomale.pdf

E E

F F

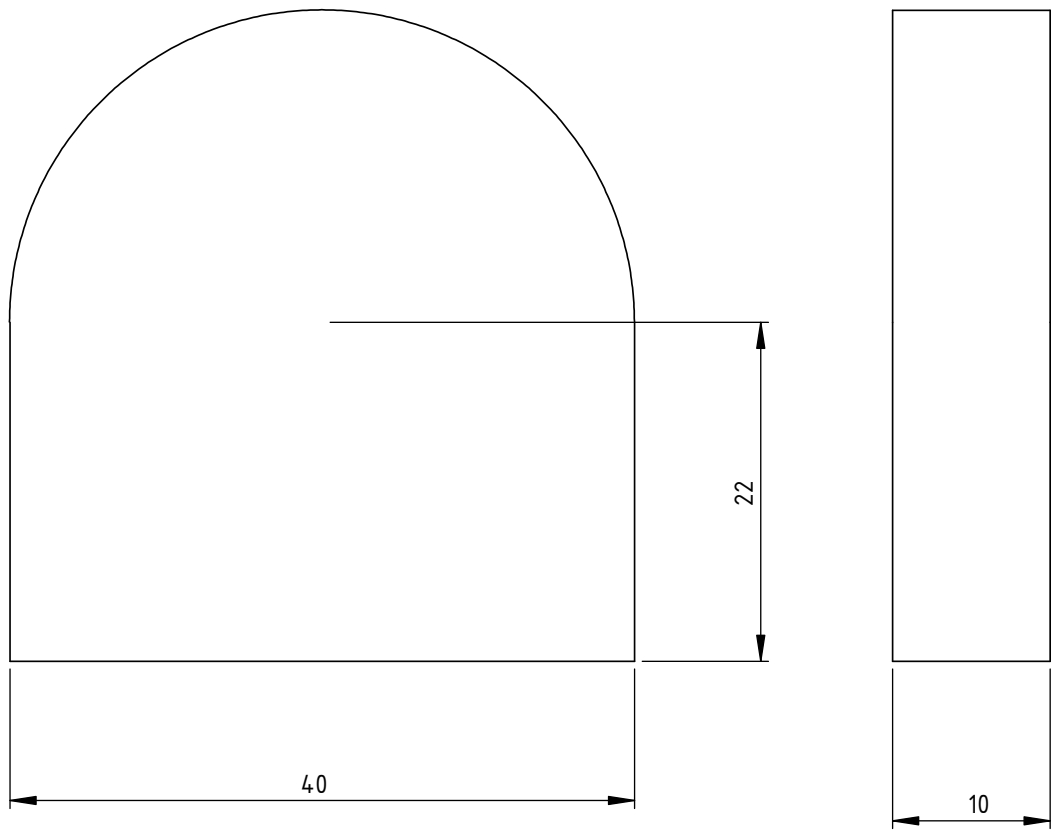
[picture p73: page 1]
Numer rysunku; Rysował; Projektował; Tytuł Imię i nazwisko; Data; Podpis; Jakub Głowacki; Arkusz 1 z 1; Skala 1:1; PKR-JG_03.03; ITLiMS; Politechnika Warszawska; Ucho małe

Produkt SOLIDWORKS Educational. Tylko do użytku instruktażowego.
