j-glow/chwytak/PDF/blok_wyko.pdf

E E

F F

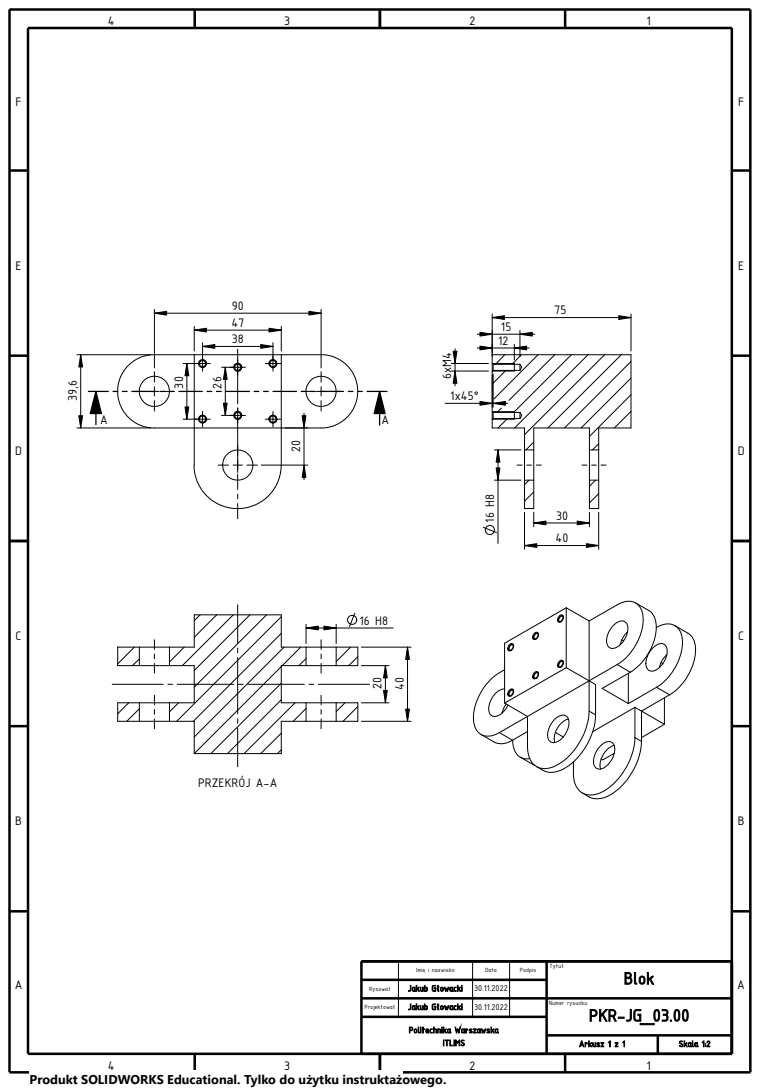
[picture p74: page 1]
Numer rysunku; Rysował; Projektował; Tytuł Imię i nazwisko; Data; Podpis; Jakub Głowacki; Arkusz 1 z 1; Skala 1:2; PKR-JG_03.00; ITLiMS; Politechnika Warszawska; Blok ³⁰; PRZEKRÓJ A-A; 6xM⁴

Produkt SOLIDWORKS Educational. Tylko do użytku instruktażowego.
