j-glow/chwytak/PDF/lyzka_bok.pdf

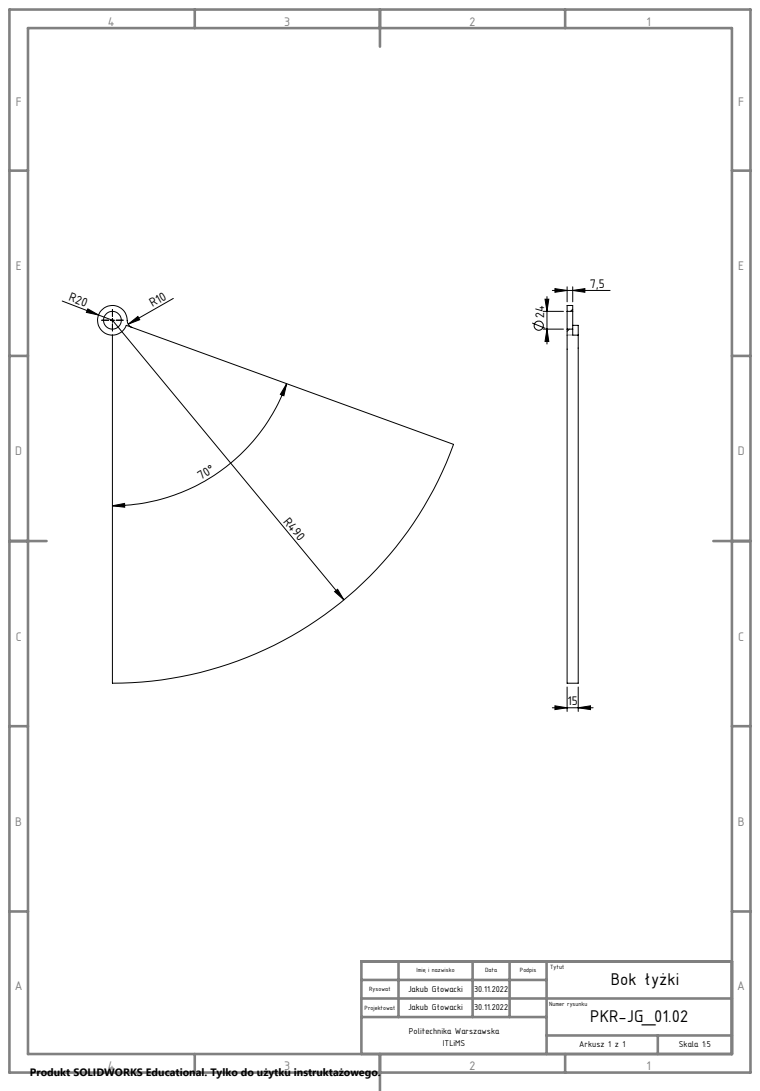
[picture p75: page 1]
Arkusz 1 z 1; Skala 1:5; Politechnika Warszawska; Bok łyżki A

Data | Podpis | Tytuł Imię i nazwisko

Rysował | Jakub Głowacki | 30.11.2022

Projektował | Jakub Głowacki | 30.11.2022 | | PKR-JG_01.02 Numer rysunku

Produkt SOLIDWORKS Educational. Tylko do użytku instruktażowego.
