j-glow/chwytak/PDF/lyzka_spaw.pdf

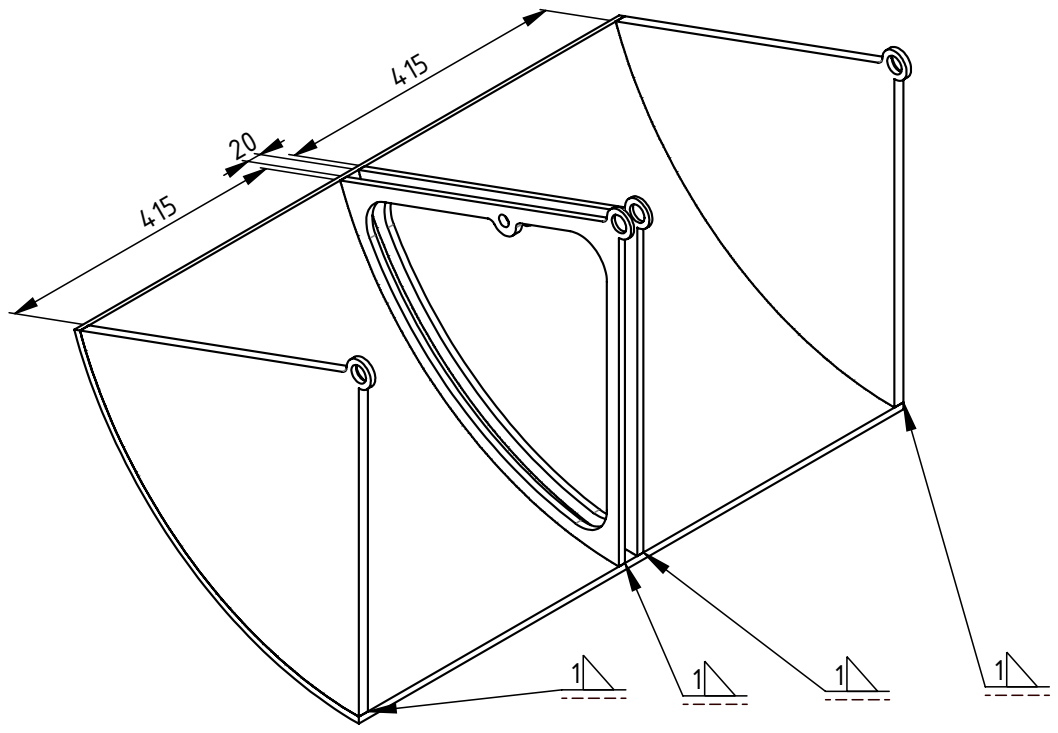
[picture p76: page 1]
Arkusz 1 z 1; Skala 1:5; Politechnika Warszawska

3 | Żebro | 2 | S355J2G4 | PKR-JG_01.03
2 | Bok łyżki | 2 | S355J2G4 | PKR-JG_01.02
1 | Skorupa | 1 | S355J2G4 | PKR-JG_01.01
Lp. | Nazwa części | Szt. | Materiał | Numer

Data | Podpis | Tytuł Imię i nazwisko Łyżka - spaw

Rysował | Jakub Głowacki | 30.11.2022

Projektował | Jakub Głowacki | 30.11.2022 | | PKR-JG_01.04 Numer rysunku

Produkt SOLIDWORKS Educational. Tylko do użytku instruktażowego.
