j-glow/chwytak/PDF/lyzka_wyko.pdf

E E

F F

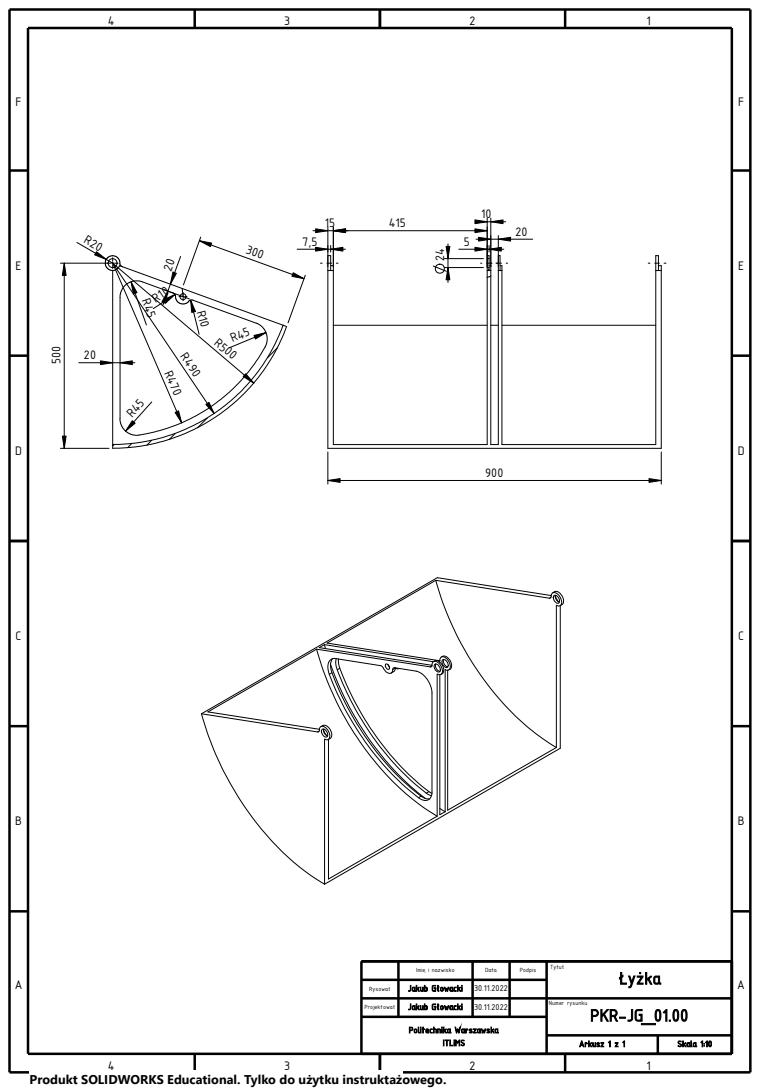
[picture p77: page 1]
Numer rysunku; Rysował; Projektował; Tytuł Imię i nazwisko; Data; Podpis; Jakub Głowacki; Arkusz 1 z 1; Skala 1:10; PKR-JG_01.00; ITLiMS; Politechnika Warszawska; Łyżka ⁵⁰⁰

Produkt SOLIDWORKS Educational. Tylko do użytku instruktażowego.
