j-glow/chwytak/PDF/lyzka_zebro.pdf

E E

F F

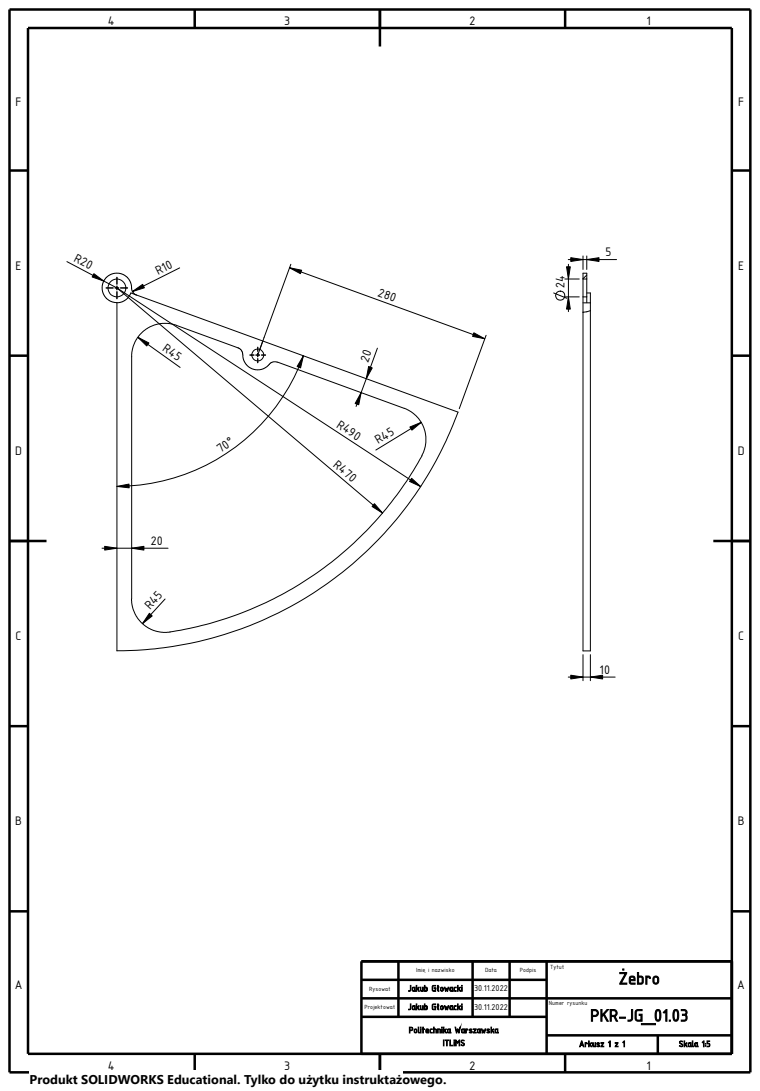
[picture p78: page 1]
Numer rysunku; Rysował; Projektował; Tytuł Imię i nazwisko; Data; Podpis; Jakub Głowacki; Arkusz 1 z 1; Skala 1:5; PKR-JG_01.03; ITLiMS; Politechnika Warszawska; Żebro ²⁴

Produkt SOLIDWORKS Educational. Tylko do użytku instruktażowego.
