j-glow/chwytak/PDF/stelaz_belkadluga.pdf

E E

F F

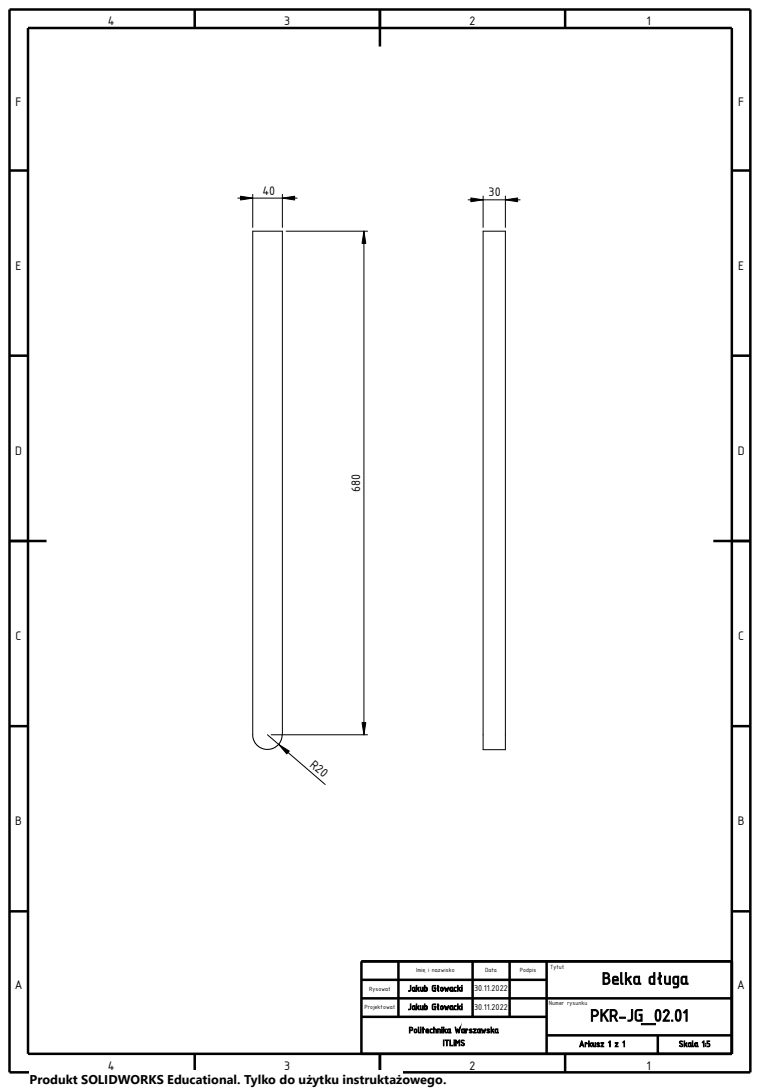
[picture p79: page 1]
Numer rysunku; Rysował; Projektował; Tytuł Imię i nazwisko; Data; Podpis; Jakub Głowacki; Arkusz 1 z 1; Skala 1:5; PKR-JG_02.01; ITLiMS; Politechnika Warszawska; Belka długa

Produkt SOLIDWORKS Educational. Tylko do użytku instruktażowego.
