j-glow/chwytak/PDF/stelaz_wyko.pdf

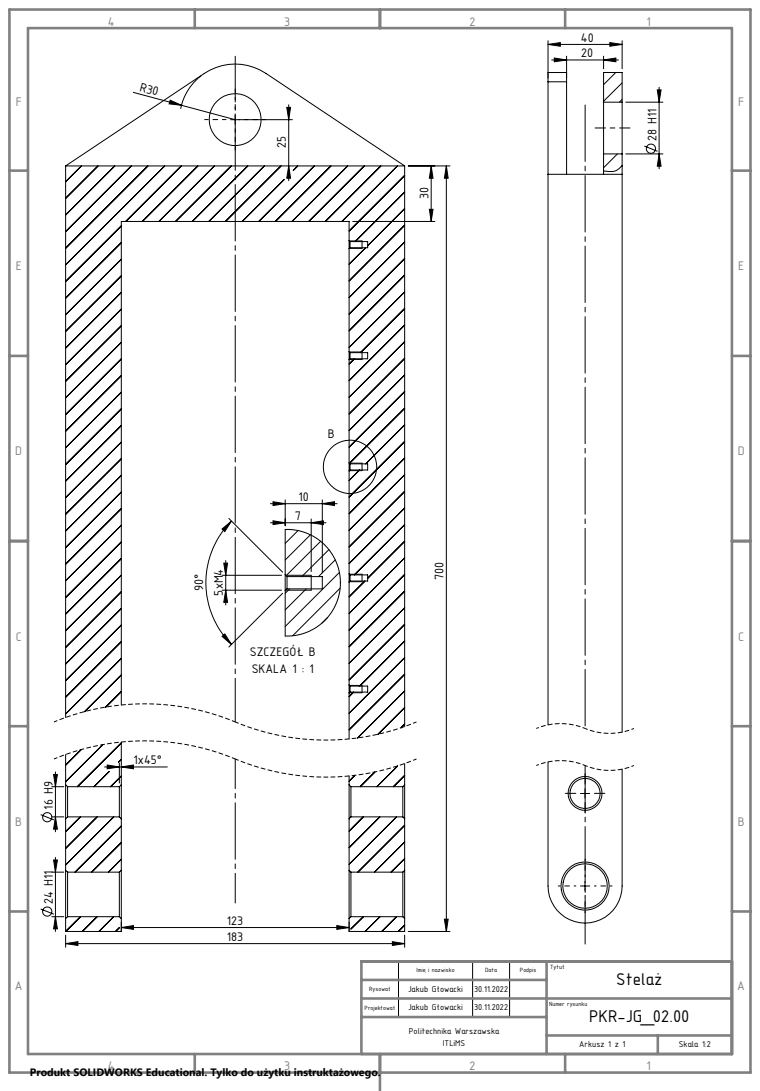
[picture p80: page 1]
SZCZEGÓŁ B SKALA 1 : 1; Arkusz 1 z 1; Skala 1:2; Politechnika Warszawska

Data | Podpis | Tytuł Imię i nazwisko Stelaż

Rysował | Jakub Głowacki | 30.11.2022

Projektował | Jakub Głowacki | 30.11.2022 | | PKR-JG_02.00 Numer rysunku

Produkt SOLIDWORKS Educational. Tylko do użytku instruktażowego.
