j-glow/chwytak/PDF/stelaż_spaw.pdf

2

E E

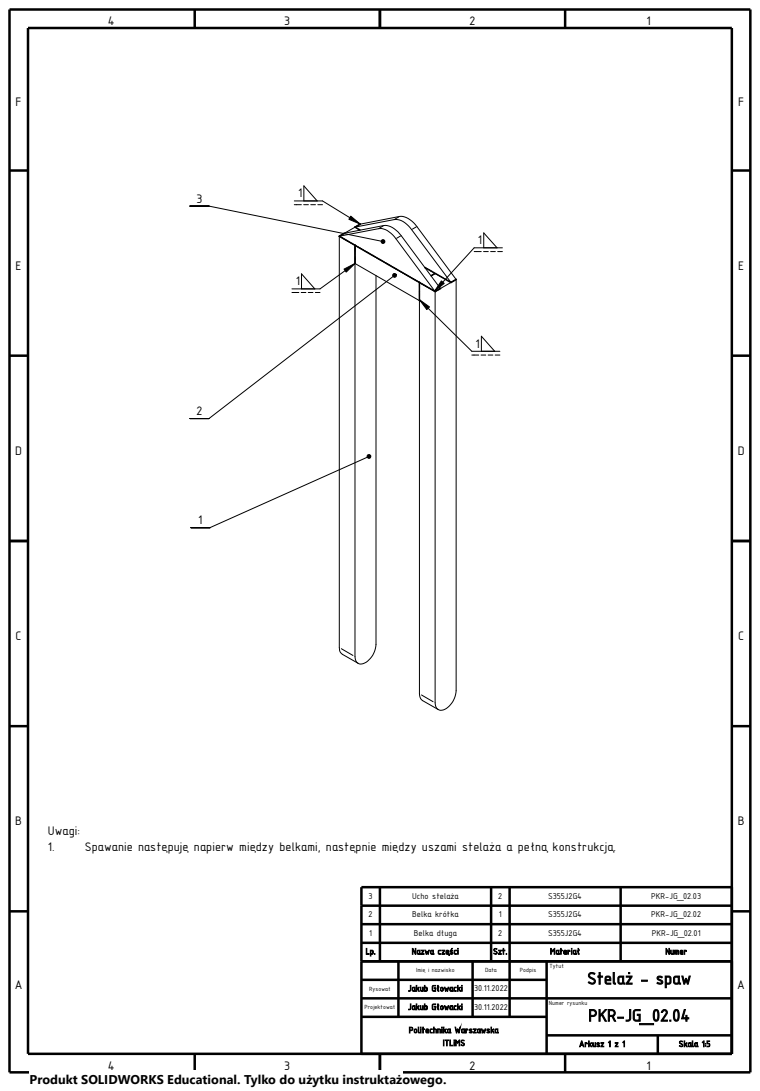
[picture p81: page 1]
Rysował; Projektował; Jakub Głowacki; Arkusz 1 z 1; ITLiMS; Skala 1:5; PKR-JG_02.04; Numer rysunku; Politechnika Warszawska

Uwagi:
1. Spawanie następuję napierw między belkami, następnie między uszami stelaża a pełną konstrukcją.

3 | Ucho stelaża | 2 | S355J2G4 | PKR-JG_02.03
2 | Belka krótka | 1 | S355J2G4 | PKR-JG_02.02
1 2 | Belka długa | | S355J2G4 | PKR-JG_02.01
Lp. | | Szt. | Materiał | Numer Nazwa części

Data | Podpis | Tytuł Imię i nazwisko Stelaż - spaw

Produkt SOLIDWORKS Educational. Tylko do użytku instruktażowego.
